Marksman124/center_control/center_control_app/readme.txt

config：

Run #1：

fromelf --bin --output=.\center_control_app\center_control_app.bin .\center_control_app\center_control_app.axf

Run #2：
.\after_build_script.bat "$J\..\bin" "#L" "$L@L.bin"
