Marksman124/center_control/center_control_box/readme.txt

config：

Run #1：

fromelf --bin --output=.\Output\center_control_box.bin .\center_control_box\center_control_box.axf

Run #2：
fromelf --bin --output=..\..\center_control_app\Bin\center_control_box.bin .\center_control_box\center_control_box.axf
