Marksman124/center_control/协议/中控_mcu_modbus_rtu协议V1.3.pdf

### 版本管理

版本号 | 版本时间 | 修改内容 | 修改人
V1.0 | 2023.12.12 | | 吴 珩
V1.1 | 2023.12.19 | | 吴 珩
V1.2 | 2023.12.27 | | 吴 珩
V1.3 | 2024.01.04 | | 吴 珩

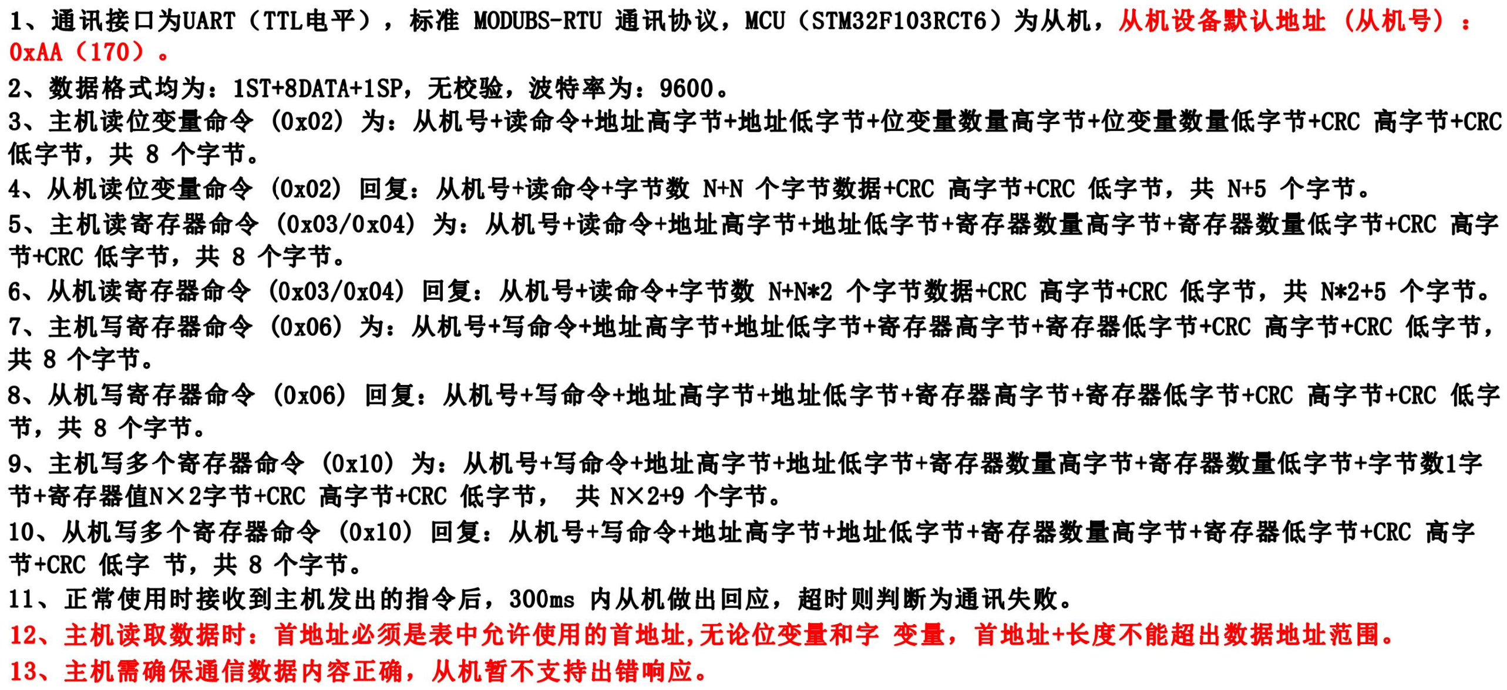
[picture p34: figure]

| | (d) | (d) | | | h | (d)
0x0000 | 从站地址 | 1~254 | 默认 170 | -- | RW | 读：0x03/写：0x06/0x10
0x0001 | 波特率 | 0~65535 | 默认 2 | bps | RW | 读：0x03/写：0x06/0x10 | 1:4800,2:9600,3:19200, 4：115200
0x0002~ 0x0009 | 预留 | | | | | 读：0x03/写：0x06/0x10
0x0010 | 水泵1转速档位 | 0~8 | 默认 0 | -- | RW | 读：0x03/写：0x06/0x10 | 0：断开，1：关闭，2:100%， 3:80%，4:40%
0x0011 | 水泵2转速档位 | 0~8 | 默认 0 | -- | RW | 读：0x03/写：0x06/0x10 | 0：断开，1：关闭，2:100%， 3:80%，4:40%
0x0012 | 水泵1转速输出电流 | 0~100 | 默认 0 | % | RW | 读：0x03/写：0x06/0x10 | 对应4~20mA输出
0x0013 | 水泵2转速输出电流 | 0~100 | 默认 0 | % | RW | 读：0x03/写：0x06/0x10 | 对应4~20mA输出
0x0014 | 水泵1转速输出电压 | 0~4095 | 默认 0 | -- | RW | 读：0x03/写：0x06/0x10 | 对应0~10V输出
0x0015 | 水泵2转速输出电压 | 0~4095 | 默认 0 | -- | RW | 读：0x03/写：0x06/0x10 | 对应0~10V输出
0x0016~ 0x001F | 预留 | | | | | 读：0x03/写：0x06/0x10
0x0020 | 电量计量模块接线方式 | 0~3 | 默认 0 | -- | RW | 读：0x03/写：0x06/0x10 | 0：无模块，1：单相，2：三相三 线，3：三相四线
0x0021 | 电量计量清零 | 1 | 默认 0 | -- | RW | 读：0x03/写：0x06/0x10 | 写入1清零后该地址自动设置为0
0x0022 | 电量计量模块地址 | 0~247 | 默认 0 | -- | RW | 读：0x03/写：0x06/0x10
0x0023 | 电量计量模块波特率 | 0~5 | 默认 0 | -- | RW | 读：0x03/写：0x06/0x10 | 0：无模块，1：2400，2：4800， 3：9600，4：19200，5：115200
0x0024 | 电量计量模块通信格式 | 0~1 | 默认 0 | -- | RW | 读：0x03/写：0x06/0x10 | 0：无模块 1:8数据位，无校验，1停止位

0x0025~ 0x002F | 预留 | | | | | 读：0x03/写：0x06/0x10
0x0030 | DMX512数据长度 | 0~512 | 默认 0 | -- | RW | 读：0x03/写：0x06/0x10 | 灯数据字节数
0x0031~ 0x003F | 预留 | | | | | 读：0x03/写：0x06/0x10
0x0040~ 0x013F | DMX512数据区 | 0~0xFFFF | 默认 0 | | RW | 读：0x03/写：0x06/0x10 | 1个地址存放2个字节灯数据， 0x0040为第1和2个灯数据字节， 往后依次顺延
| | (d) | (d) | | | h | (d)
0x0000 | 软件版本1 | | | -- | R | 读：0x04 / 写：-- | 软件版本高16位
0x0001 | 软件版本2 | | | -- | R | 读：0x04 / 写：-- | 软件版本低16位
0x0002 | 模拟量水位开关状态 | | | m | R | 读：0x04 / 写：-- | 实际水位高度
0x0003~ 0x000F | 预留 | | | -- | R | 读：0x04 / 写：--
0x0010~ 0x0011 | 电网频率 | | | 0.01Hz | R | 读：0x04 / 写：-- | 单相/三相共用，无符号数
0x0012 | 电量计量模块状态字1 | 0~0xFFFF | | -- | R | 读：0x04 / 写：--
0x0013 | 电量计量模块状态字2 | 0~0xFFFF | | -- | R | 读：0x04 / 写：--
0x0014~ 0x0015 | 有功总电能 | | | 0.0001 /0.001 kWh | R | 读：0x04 / 写：-- | 0x0014：高16位，0x0015：低16 位，下同 单相单位：0.0001kWh，无符号数 三相单位：0.001kWh，有符号数
0x0016~ 0x0017 | 正向有功总电能 | | | 0.001 kWh | R | 读：0x04 / 写：-- | 仅三相有效，无符号数
0x0018~ 0x0019 | 反向有功总电能 | | | 0.001 kWh | R | 读：0x04 / 写：-- | 仅三相有效，无符号数

5 0x001A~ 0x001B | 总有功功率 | 0.0001 W/0.00 01kW | R | 读：0x04 / 写：-- | 单相单位：0.0001W，无符号数 三相单位：0.0001kW，有符号数 0x001C~ 0x001D | 总无功功率 | 0.0001 kvar | R | 读：0x04 / 写：-- | 仅三相有效，有符号数 0x001E~ 0x001F | 总视在功率 | 0.0001 kVA | R | 读：0x04 / 写：-- | 仅三相有效，有符号数 0x0020~ 0x0021 | 总功率因素 | 0.001 | R | 读：0x04 / 写：-- | 单相无符号数，三相有符号数 0x0022~ 0x0023 | A相电压 | 0.0001 /0.1V | R | 读：0x04 / 写：-- | 单相单位：0.0001V，无符号数 三相单位：0.1V，无符号数 0x0024~ 0x0025 | A相电流 | 0.0001 /0.001 A | R | 读：0x04 / 写：-- | 单相单位：0.0001A，无符号数 三相单位：0.001A，有符号数 0x0026~ 0x0027 | B相电压 | 0.1V | R | 读：0x04 / 写：-- | 仅三相有效，无符号数 0x0028~ 0x0029 | B相电流 | 0.001A | R | 读：0x04 / 写：-- | 仅三相有效，有符号数 0x002A~ 0x002B | C相电压 | 0.1V | R | 读：0x04 / 写：-- | 仅三相有效，无符号数 0x002C~ 0x002D | C相电流 | 0.001A | R | 读：0x04 / 写：-- | 仅三相有效，有符号数 0x002E~ 0x002F | 零线电流 | 0.001A | R | 读：0x04 / 写：-- | 仅零线接入互感器有效，，有符 号数，预留 0x0030~ 0x003F | 预留 | R | 读：0x04 / 写：--

注：参数的设置范围与默认值请以说明书为标准。

OTA文件传输协议基于modbus-rtu协议21（0x15）写文件记录功能码指令实现，使用该功能码进行文件记录写入，根据字节数量提供所有请求数据

长度，并且根据16比特字的数量提供所有记录长度。用含有7个字节针对每一帧中每一个数据包进行描述：

参考类型 | 1个字节（必须规定为6）
文件号 | 2个字节，默认为：0x0001，代表MCU OTA文件
文件中的起始记录号 | 2个字节，可以作为文件包号
被写入的记录长度 | 2个字节，该包数据长度，2个字节为1个长度
被写入的记录数据 | 每一包的OTA文件内容，2个字节的整数倍（偶数）
- 注：MCU发布的OTA文件保证2个字节的整数倍。

请求数据帧（APP-->MCU）

地址域 | 1个字节 | MCU地址，默认：170（0xAA）
请求数据长度 | 1个字节 | 0x07至0xF5
参考类型 | 1个字节 | 固定为：0x06
文件号 | 2个字节 | 0x0000至0xFFFF，默认为：0x0001，代表MCU OTA文件
记录号 | 2个字节 | 0x0000至0x270F，可以作为文件包号，0xFFFF为最后一个包
记录长度 | 2字节 | N，该包数据长度，2个字节为1个长度
记录数据 | N*2个字节
CRC16 | 2个字节
- 注：
1. 请求数据长度：参考类型（1个字节）+文件号（2个字节）+记录号（2个字节）+记录长度（2个字节）+记录数据 总的字节数（固定有7个字节）。
2. 一个OTA文件包数据记录长度N最大为：（0xF5-0x07）/2=0xEE/2=0x77（119），即一个OTA文件包数据最多为119*2=238字节。
| | (d) | (d) | | h | (d)
0x0000~ 0x00100 | 预留 | | | R | 读：0x02 / 写：--

响应数据帧（APP<--MCU）

地址域 | 1个字节 | MCU地址，默认：170（0xAA）
请求数据长度 | 1个字节 | 0x07至0xF5
参考类型 | 1个字节 | 固定为：0x06
文件号 | 2个字节 | 0x0000至0xFFFF，默认为：0x0001，代表MCU OTA文件
记录号 | 2个字节 | 0x0000至0x270F，可以作为文件包号，0xFFFF为最后一个包
记录长度 | 2字节 | N，该包数据长度，2个字节为1个长度
CRC16 | 2个字节
例程：
请求 | 响应
数据域 | （十六进制） | 备注 | 数据域 | （十六进制） | 备注
地址域 | AA | MCU从站地址，默认0xAA（170） | 地址域 | AA | MCU从站地址，默认0xAA（170）
功能码 | 15 | OTA文件传输功能码指令 | 功能码 | 15 | OTA文件传输功能码指令
请求数据长度 | 0D | 从参考类型至CRC_H（不包含）的总 数据字节数，其中： 参考类型（1字节）+文件号（2字节 ）+记录号（2字节）+记录长度（2字 节）=7字节（固定），记录数据6字 节，共计：7+6=13（0x0D）字节 | 请求数据长度 | 0D | 从参考类型至CRC_H（不包含）的总 数据字节数，其中： 参考类型（1字节）+文件号（2字节 ）+记录号（2字节）+记录长度（2字 节）=7字节（固定），记录数据6字 节，共计：7+6=13（0x0D）字节
参考类型 | 06 | 固定默认为06 | 参考类型 | 06 | 固定默认为06
文件号Hi | 00 | MCU的OTA文件，默认0x0001 | 文件号Hi | 00 | MCU的OTA文件，默认0x0001 文件号Lo
| 01 | | 文件号Lo | 01
记录号Hi | 00 07 | 当前传输包号为7（从0开始计算） | 记录号Hi 记录号Lo | 00 07 | 当前传输包号为7（从0开始计算） 记录号Lo
记录长度Hi | 00 | 包号为7的数据内容长度，本例为3， 共3*2=6字节 | 记录长度Hi | 00 | 包号为7的数据内容长度，本例为3， 共3*2=6字节
记录长度Lo | 03 | | 记录长度Lo | 03
记录数据Hi | 06 | 包号为7的文件数据内容，不需要进 行大端高/低字节交换，按照读取OTA 文件该包号从低到高字节（2字节倍 数）顺序发送即可。 | CRC_H | CF | CRC_H（不包含）以上所有字节CRC16 校验结果数据
记录数据Lo | AF | | CRC_L | AC
记录数据Hi | 04
记录数据Lo | BE
记录数据Hi | 10
记录数据Lo | 0D

CRC_H | F8 | CRC_H（不包含）以上所有字节CRC16 校验结果数据
CRC_L | 88
- 注：Hi对应高字节，Lo对应低字节，CRC_H对应CRC高字节，CRC_L对应CRC低字节。
