Marksman124/center_control/资料/IM1275电能计量模块资料包V1.4/IM1275计量院测试报告.pdf

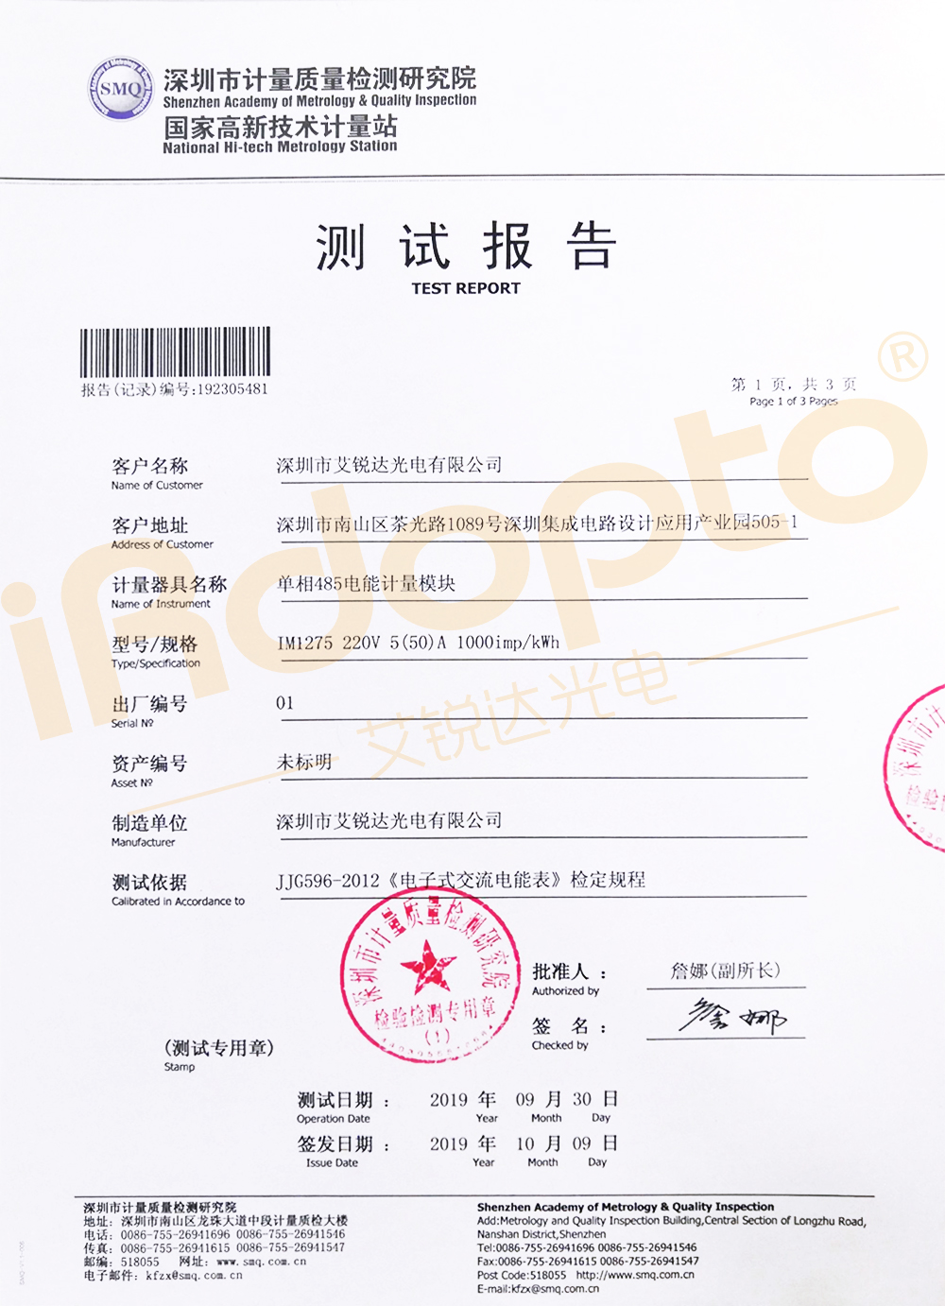
[picture p35: page 1]
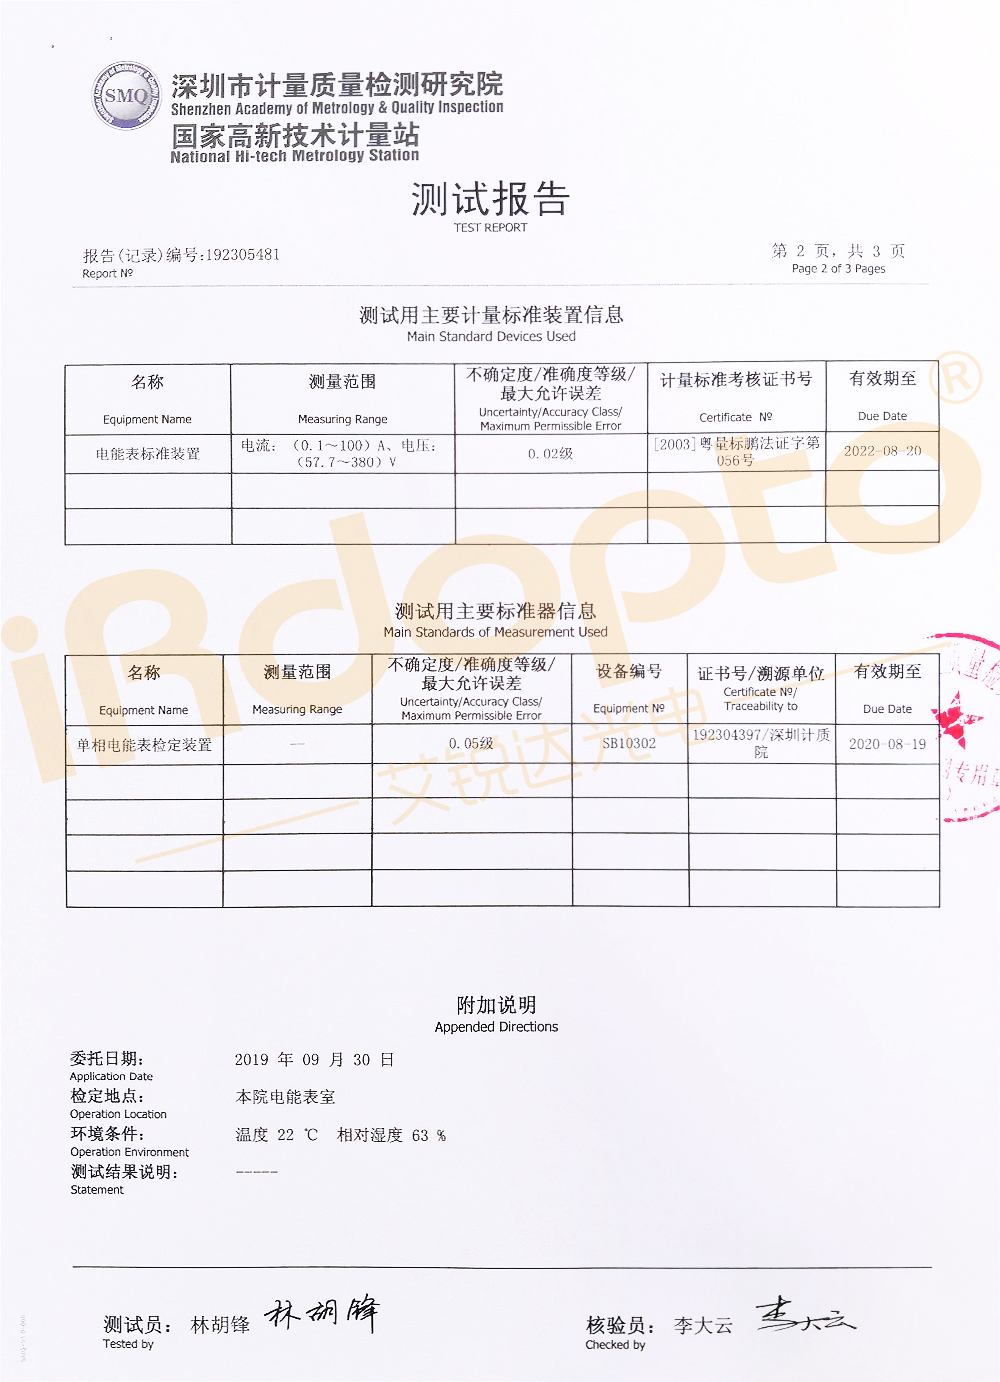
[picture p36: page 2]
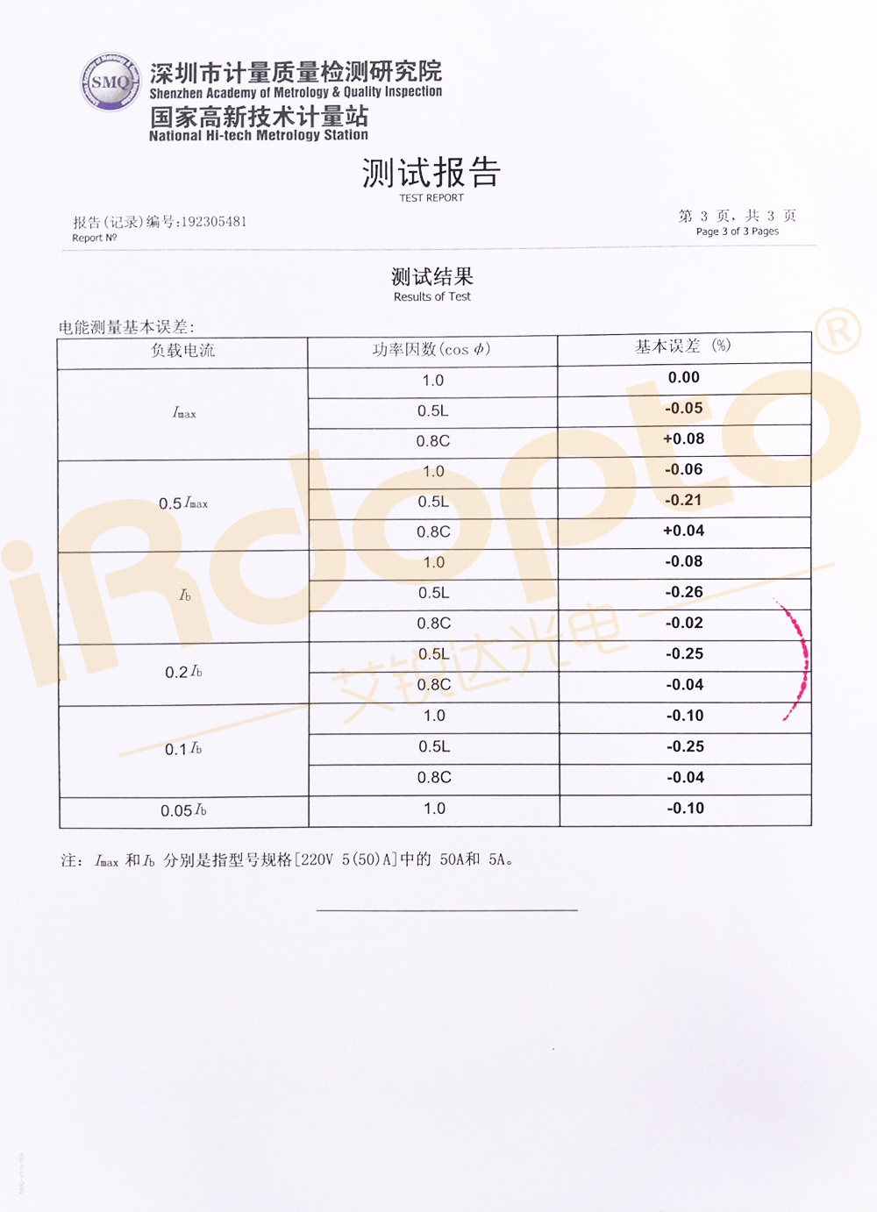
[picture p37: page 3]
