Marksman124/center_control/资料/IM3332三相电能计量模块资料包V1.3/IM3332 计量院检测报告202209.pdf

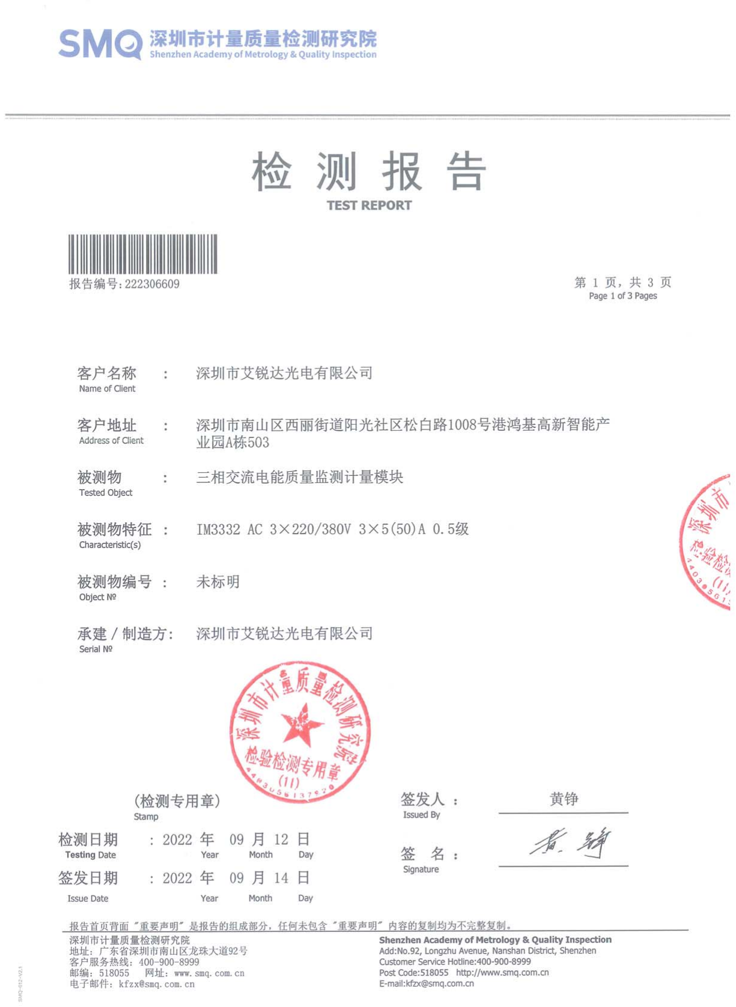
[picture p38: page 1]
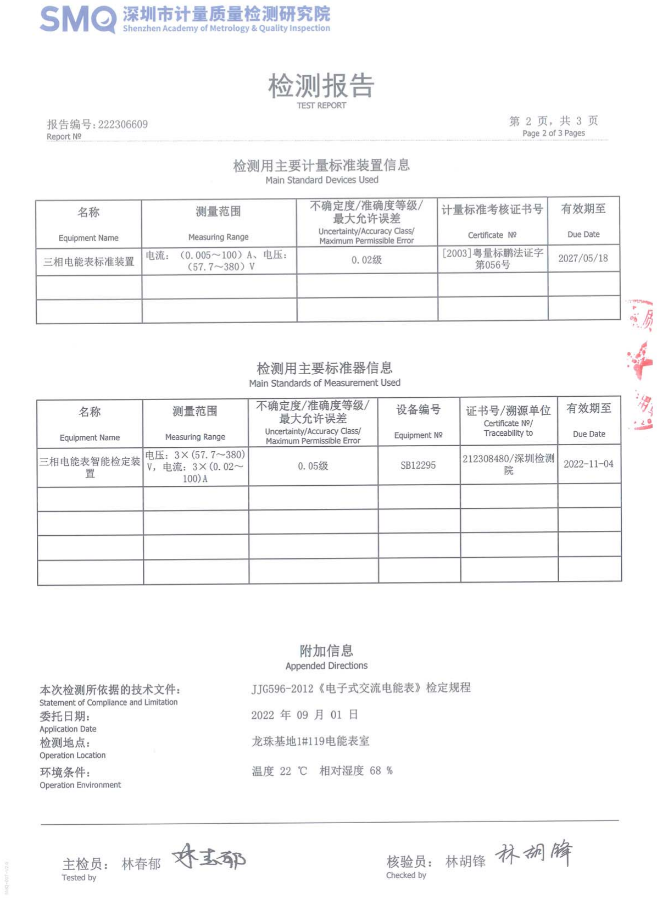
[picture p39: page 2]
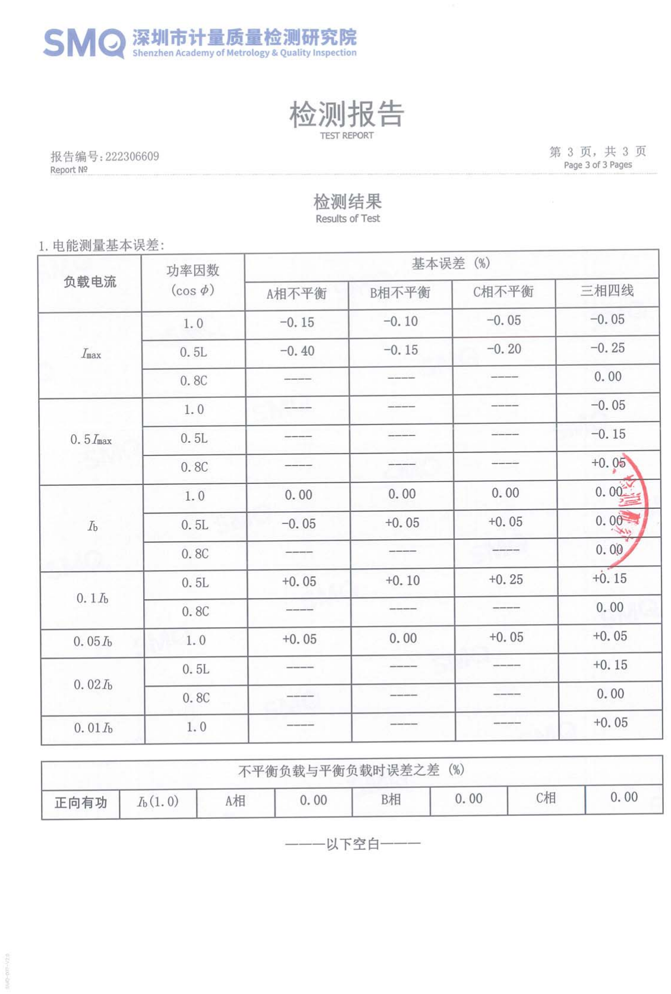
[picture p40: page 3]
