Marksman124/center_control/协议/中控_mcu_modbus_rtu协议V1.0.pdf

版本管理 版本号 | 版本时间 | 修改内容 | 修改人 V1.0 | 2023.12.12 | 吴 珩


| | (d) | (d) | | | h | (d)
0x0000 | 从站地址 | 1~254 | 默认 170 | -- | RW | 读：0x03/写：0x06/0x10
0x0001 | 波特率1 | 0~65535 | 默认 9600 | bps | RW | 读：0x03/写：0x06/0x10 | 波特率低16位
0x0002 | 波特率2 | 0~65535 | 默认 0 | bps | RW | 读：0x03/写：0x06/0x10 | 波特率高16位
0x0003~ 0x0009 | 预留 | | | | | 读：0x03/写：0x06/0x10
0x0010 | 水泵1转速档位 | 0~8 | 默认 0 | -- | RW | 读：0x03/写：0x06/0x10 | 0：关闭，值越大转速档位越高
0x0011 | 水泵2转速档位 | 0~8 | 默认 0 | -- | RW | 读：0x03/写：0x06/0x10 | 0：关闭，值越大转速档位越高
0x0012 | 水泵1转速输出电流 | 0~100 | 默认 0 | % | RW | 读：0x03/写：0x06/0x10 | 对应4~20mA输出
0x0013 | 水泵2转速输出电流 | 0~100 | 默认 0 | % | RW | 读：0x03/写：0x06/0x10 | 对应4~20mA输出
0x0014 | 水泵1转速输出电压 | 0~4095 | 默认 0 | -- | RW | 读：0x03/写：0x06/0x10 | 对应0~10V输出
0x0015 | 水泵2转速输出电压 | 0~4095 | 默认 0 | -- | RW | 读：0x03/写：0x06/0x10 | 对应0~10V输出
0x0016~ 0x0019 | 预留 | | | | | 读：0x03/写：0x06/0x10
0x0020 | 电量计量清零 | 1 | 默认 0 | -- | RW | 读：0x03/写：0x06/0x10 | 写入1清零后该地址自动设置为0
0x0020~ 0x002F | 预留 | | | | | 读：0x03/写：0x06/0x10
0x0030 | DMX512数据长度 | 0~512 | 默认 0 | -- | RW | 读：0x03/写：0x06/0x10 | 灯数据字节数
0x0031~ 0x003F | 预留 | | | | | 读：0x03/写：0x06/0x10
0x0040~ 0x013F | DMX512数据区 | 0~0xFFFF | 默认 0 | | RW | 读：0x03/写：0x06/0x10 | 1个地址存放2个字节灯数据， 0x0040为第1和2个灯数据字节， 往后依次顺延

5 | (d) | (d) | h | (d) 0x0000 | 软件版本1 | -- | R | 读：0x04 / 写：-- | 软件版本低16位 0x0001 | 软件版本2 | -- | R | 读：0x04 / 写：-- | 软件版本高16位 0x0002 | 模拟量水位开关状态 | m | R | 读：0x04 / 写：-- | 实际水位高度 0x0003~ 0x000F | 预留 | -- | R | 读：0x04 / 写：-- 0x0010 | 电量计量模块接线类型 | -- | R | 读：0x04 / 写：-- | 0x01：单相 0x55：三相四线制 0xAA：三相三线制 0x0011 | 电网频率 | Hz | R | 读：0x04 / 写：-- 0x0012 | 电量计量模块状态字1 | 0~0xFFFF | -- | R | 读：0x04 / 写：-- 0x0012 | 电量计量模块状态字2 | 0~0xFFFF | -- | R | 读：0x04 / 写：-- 0x0014 | 有功总电能 | 0.01 kWh | R | 读：0x04 / 写：-- | 单相/三相共用 0x0015 | 正向有功总电能 | 0.01 kWh | R | 读：0x04 / 写：-- | 仅三相有效 0x0016 | 反向有功总电能 | 0.01 kWh | R | 读：0x04 / 写：-- | 仅三相有效 0x0017 | 总有功功率 | 0.0001 kW | R | 读：0x04 / 写：-- | 单相/三相共用 0x0018 | 总无功功率 | 0.0001 kvar | R | 读：0x04 / 写：-- | 仅三相有效 0x0019 | 总视在功率 | 0.0001 kVA | R | 读：0x04 / 写：-- | 仅三相有效 0x0020 | 总功率因素 | 0.001 | R | 读：0x04 / 写：-- | 单相/三相共用 0x0021 | A相电压 | 0.1V | R | 读：0x04 / 写：-- | 单相/三相共用 0x0022 | A相电流 | 0.001A | R | 读：0x04 / 写：-- | 单相/三相共用 0x0023 | B相电压 | 0.1V | R | 读：0x04 / 写：-- | 仅三相有效 0x0024 | B相电流 | 0.001A | R | 读：0x04 / 写：-- | 仅三相有效

注：参数的设置范围与默认值请以说明书为标准。

0x0025 | C相电压 | 0.1V | R | 读：0x04 / 写：-- | 仅三相有效
0x0026 | C相电流 | 0.001A | R | 读：0x04 / 写：-- | 仅三相有效
0x0027~ 0x0030 | 预留 | | R | 读：0x04 / 写：--
| | (d) | (d) | | h | (d)
0x0000~ 0x00100 | 预留 | | | R | 读：0x02 / 写：--
