Marksman124/center_control/资料/IM3332三相电能计量模块资料包V1.3/IM3332定位孔尺寸.png

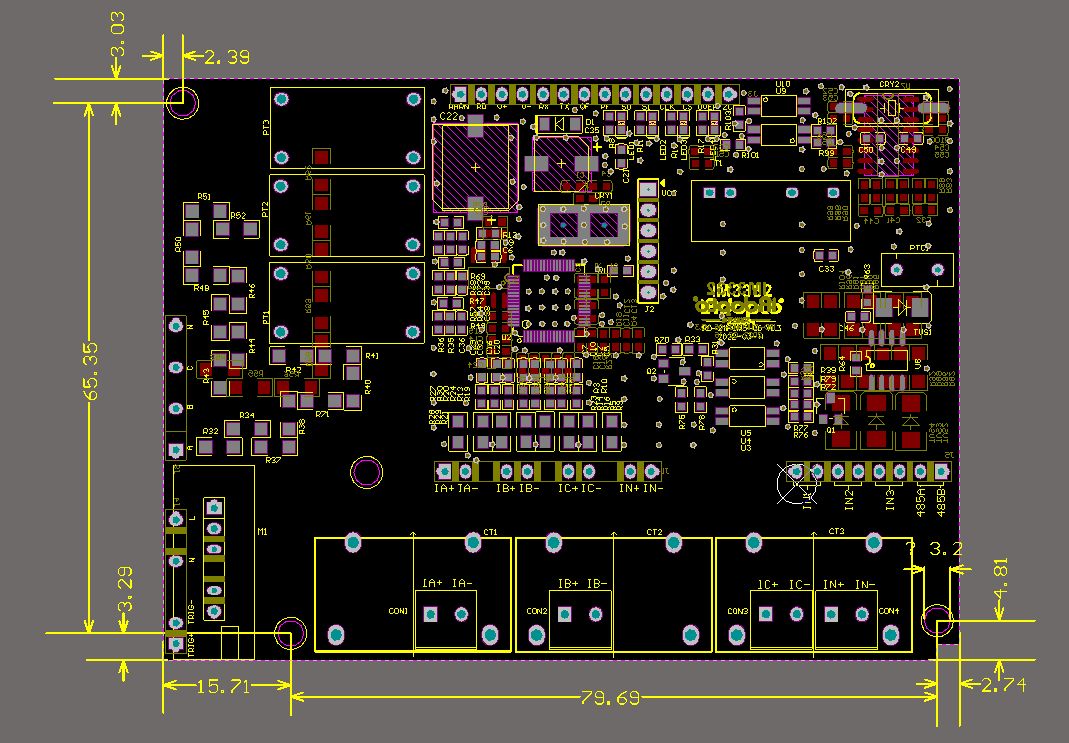
资料/IM3332三相电能计量模块资料包V1.3/IM3332定位孔尺寸.png
