Marksman124/center_control/资料/lQLPJw6vsxUtuK_NBITNAx2wI1InRiWbrwsFhp_jsBXTAQ_797_1156.png

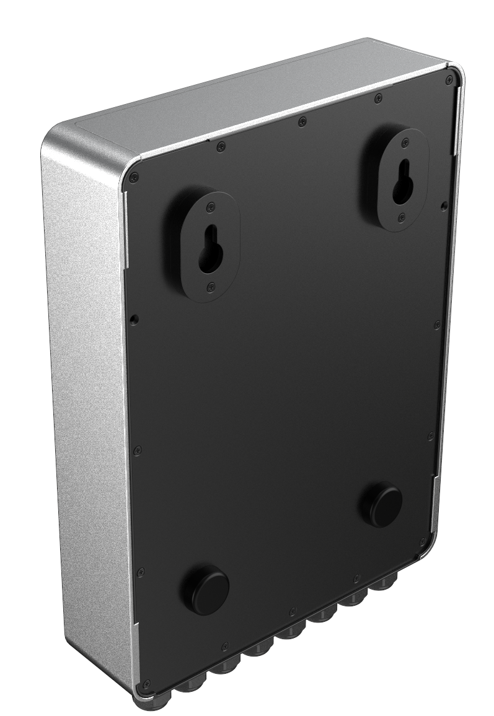
资料/lQLPJw6vsxUtuK_NBITNAx2wI1InRiWbrwsFhp_jsBXTAQ_797_1156.png
