Marksman124/center_control/资料/lQLPJwHTVCcXeK_NA9vNAwawpavTkDDjZVQFhp_jsBXTAw_774_987.png

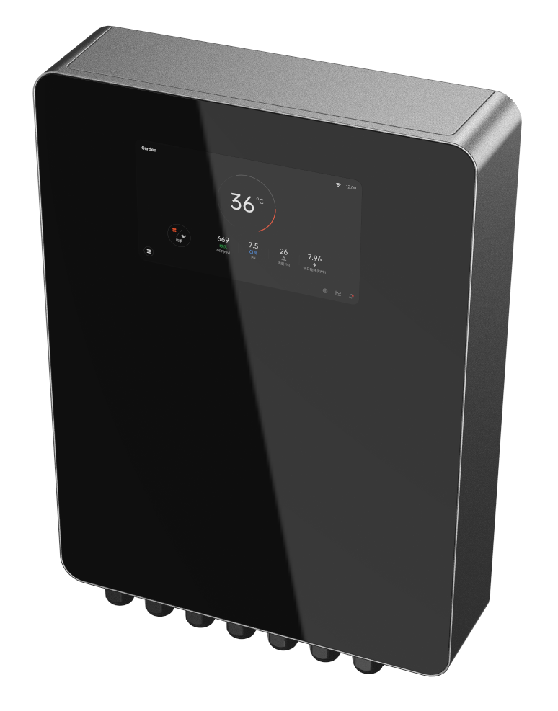
资料/lQLPJwHTVCcXeK_NA9vNAwawpavTkDDjZVQFhp_jsBXTAw_774_987.png
