Marksman124/center_control/资料/lQLPJwtq9uP8OK_NBAPNAsewVGl3I03FFfEFhp_jsBXTAA_711_1027.png

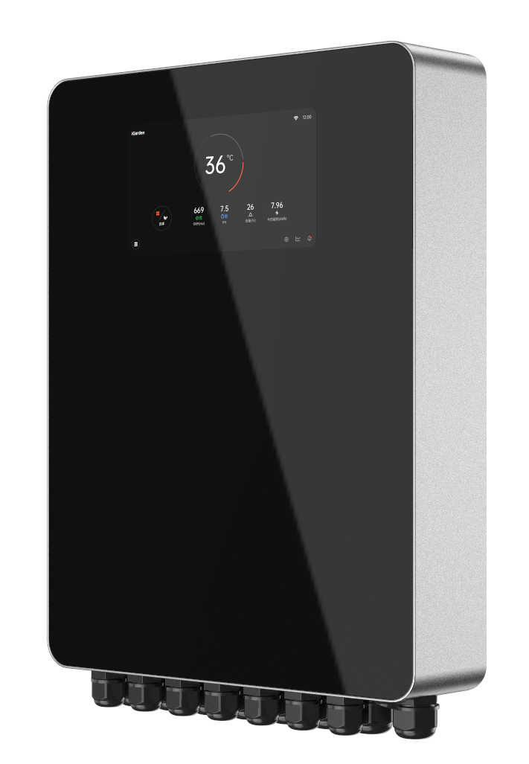
资料/lQLPJwtq9uP8OK_NBAPNAsewVGl3I03FFfEFhp_jsBXTAA_711_1027.png
