Marksman124/center_control/资料/lQLPKd925OXayK_NBDvNBFKwM_CNws2gdIkFhp_jsBXTAg_1106_1083.png

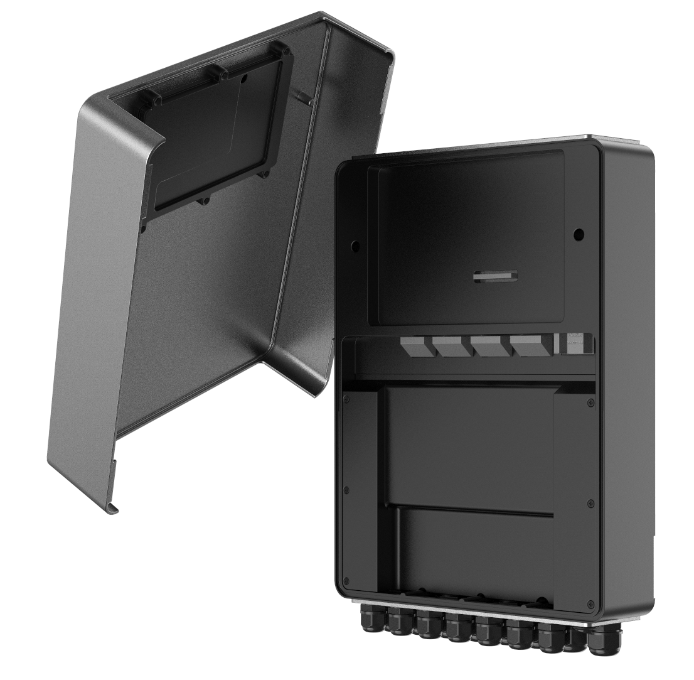
资料/lQLPKd925OXayK_NBDvNBFKwM_CNws2gdIkFhp_jsBXTAg_1106_1083.png
