Marksman124/center_control/原理图/Schematic Prints.pdf

# USB-HOST

# USB-OTG

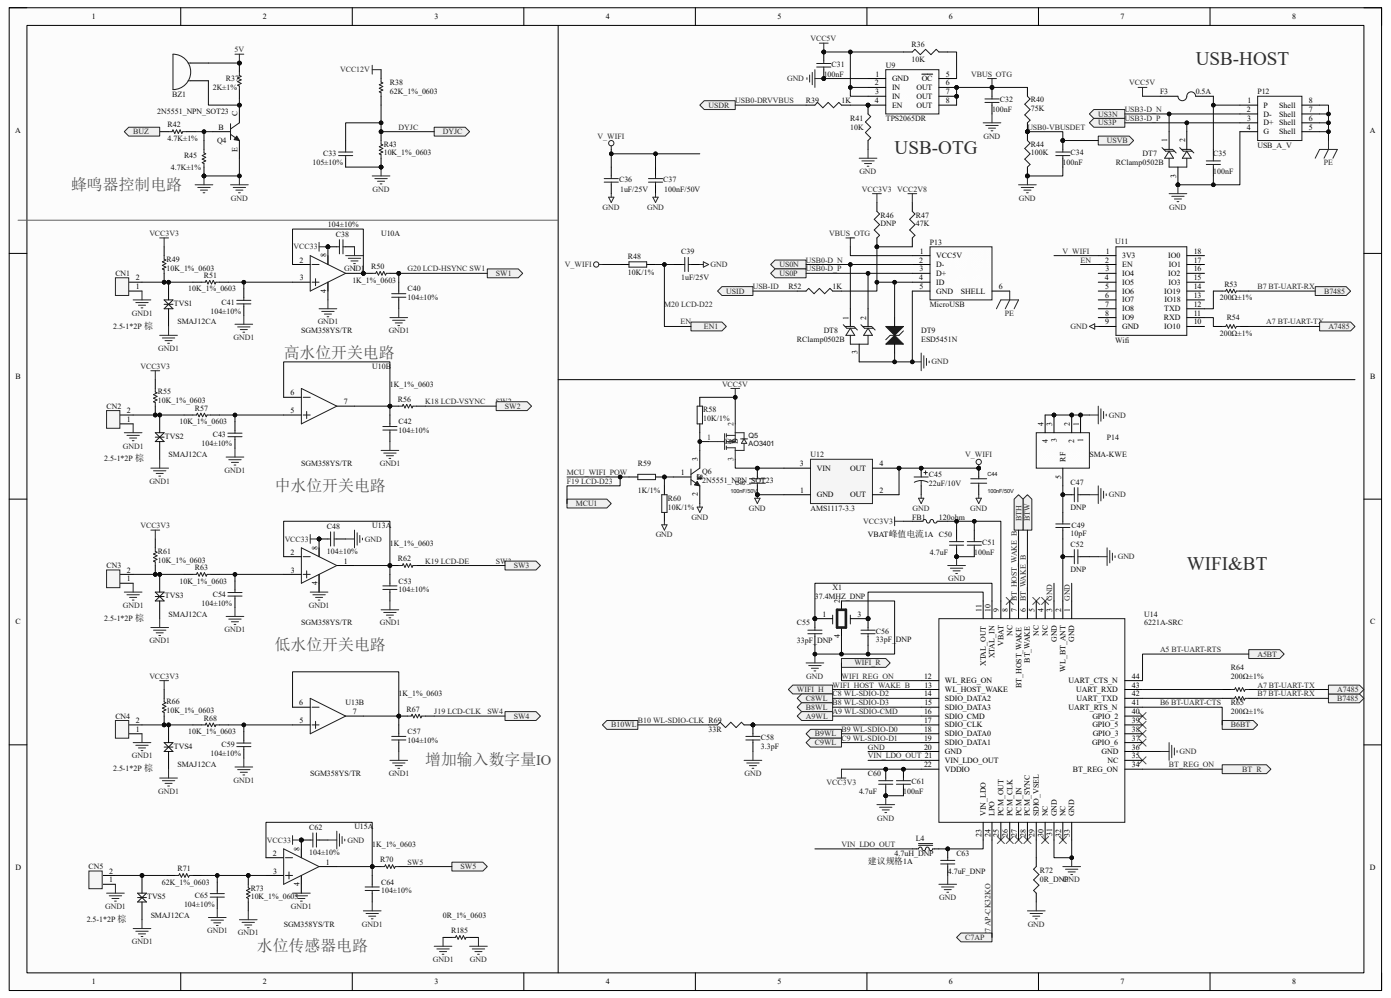
[picture p46: page 1]

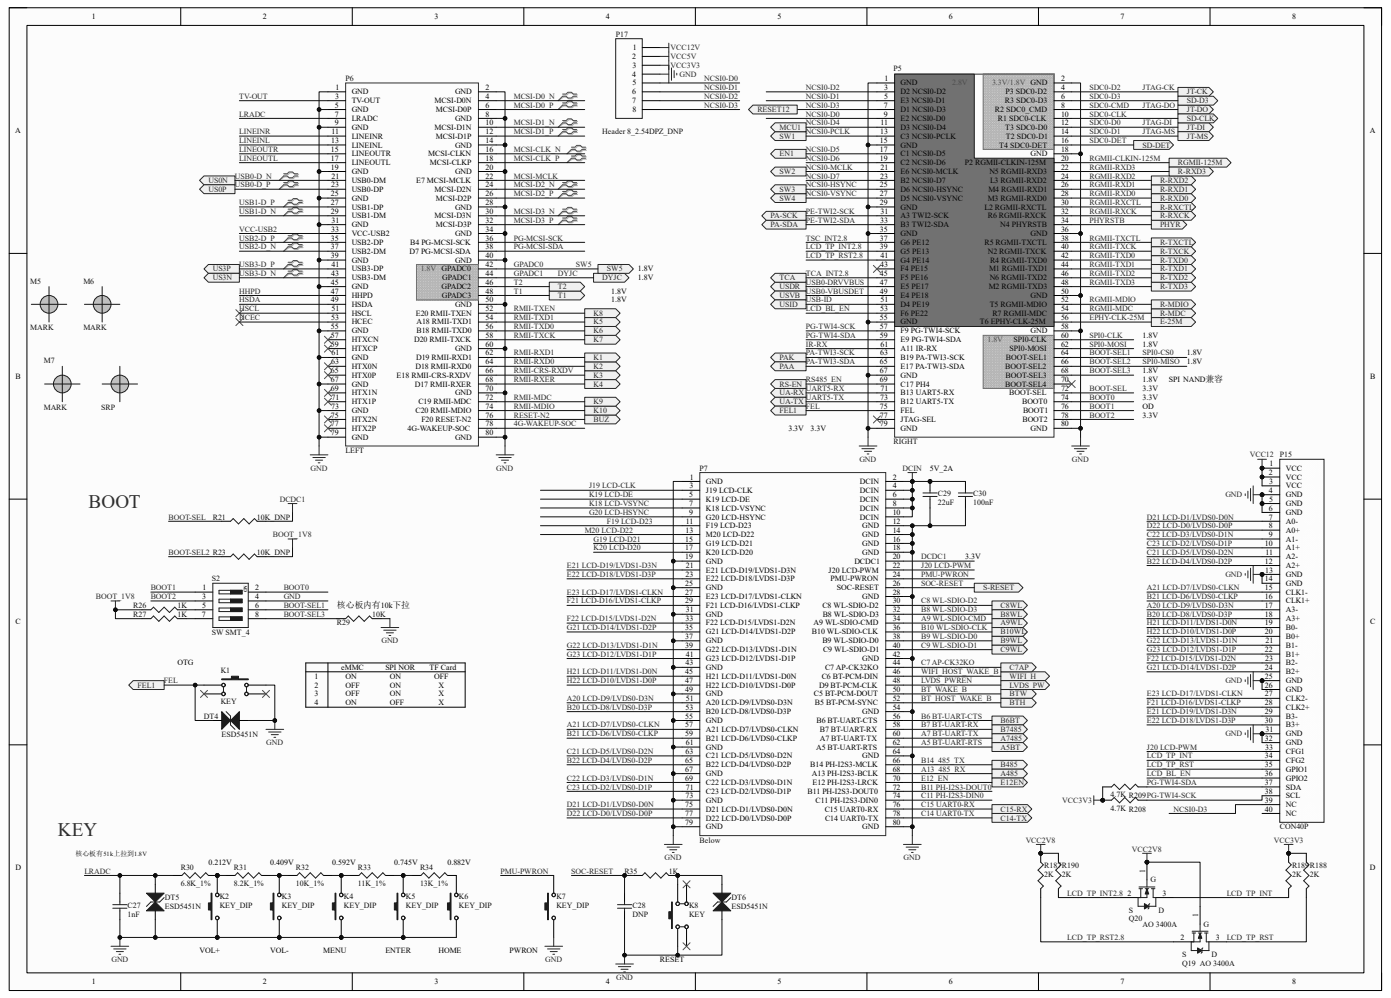
[picture p47: page 2]

# TF Card

# POWER

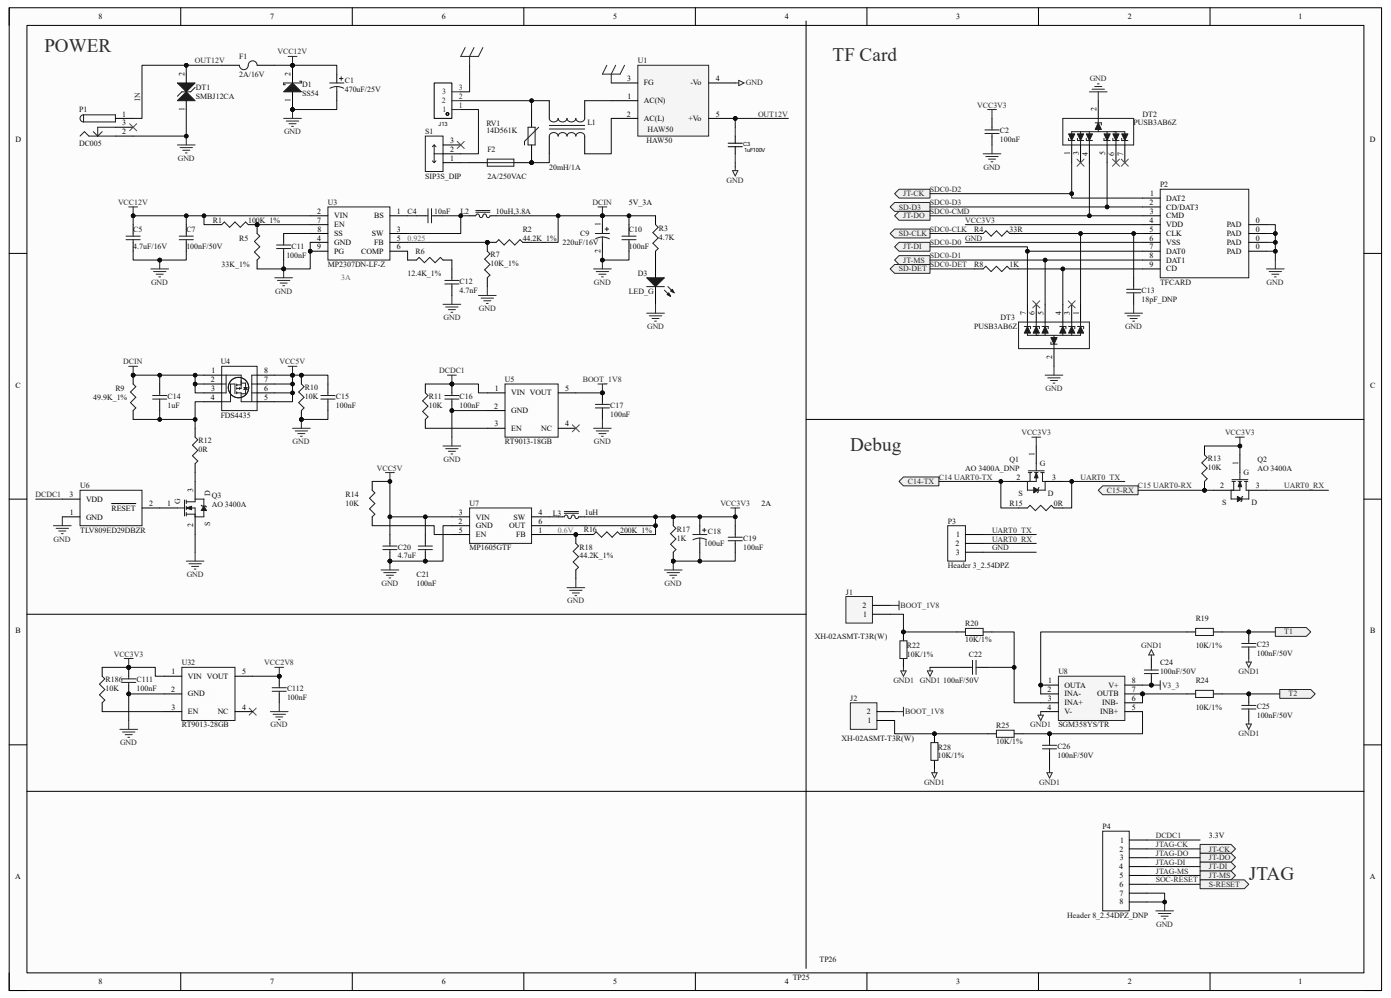
[picture p48: page 3]

LV

D

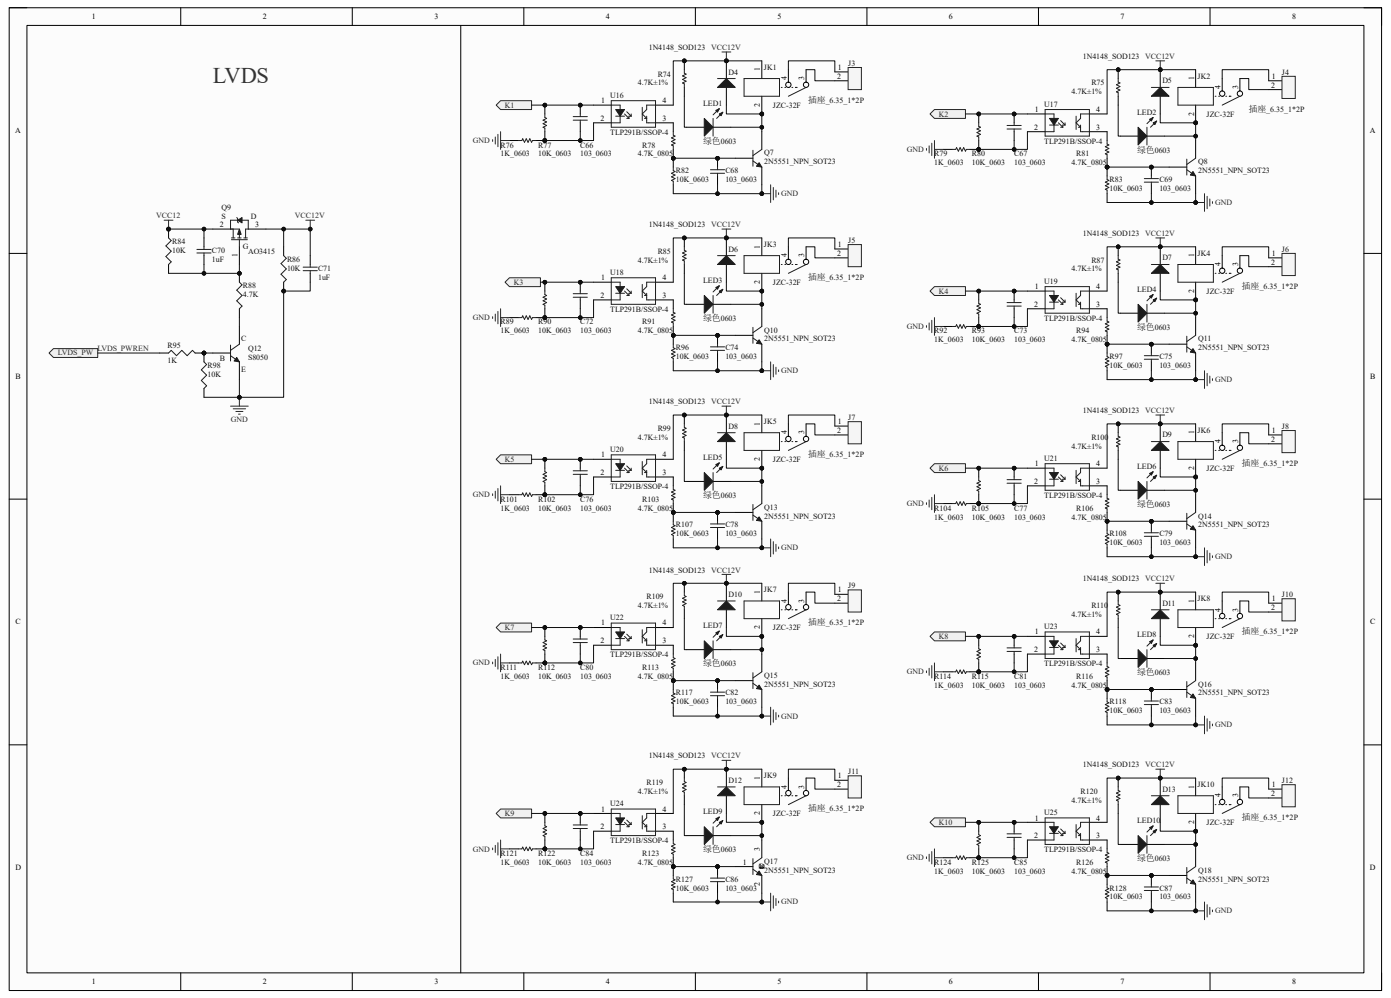
[picture p49: page 4]

# RS485通信电路

0~10V

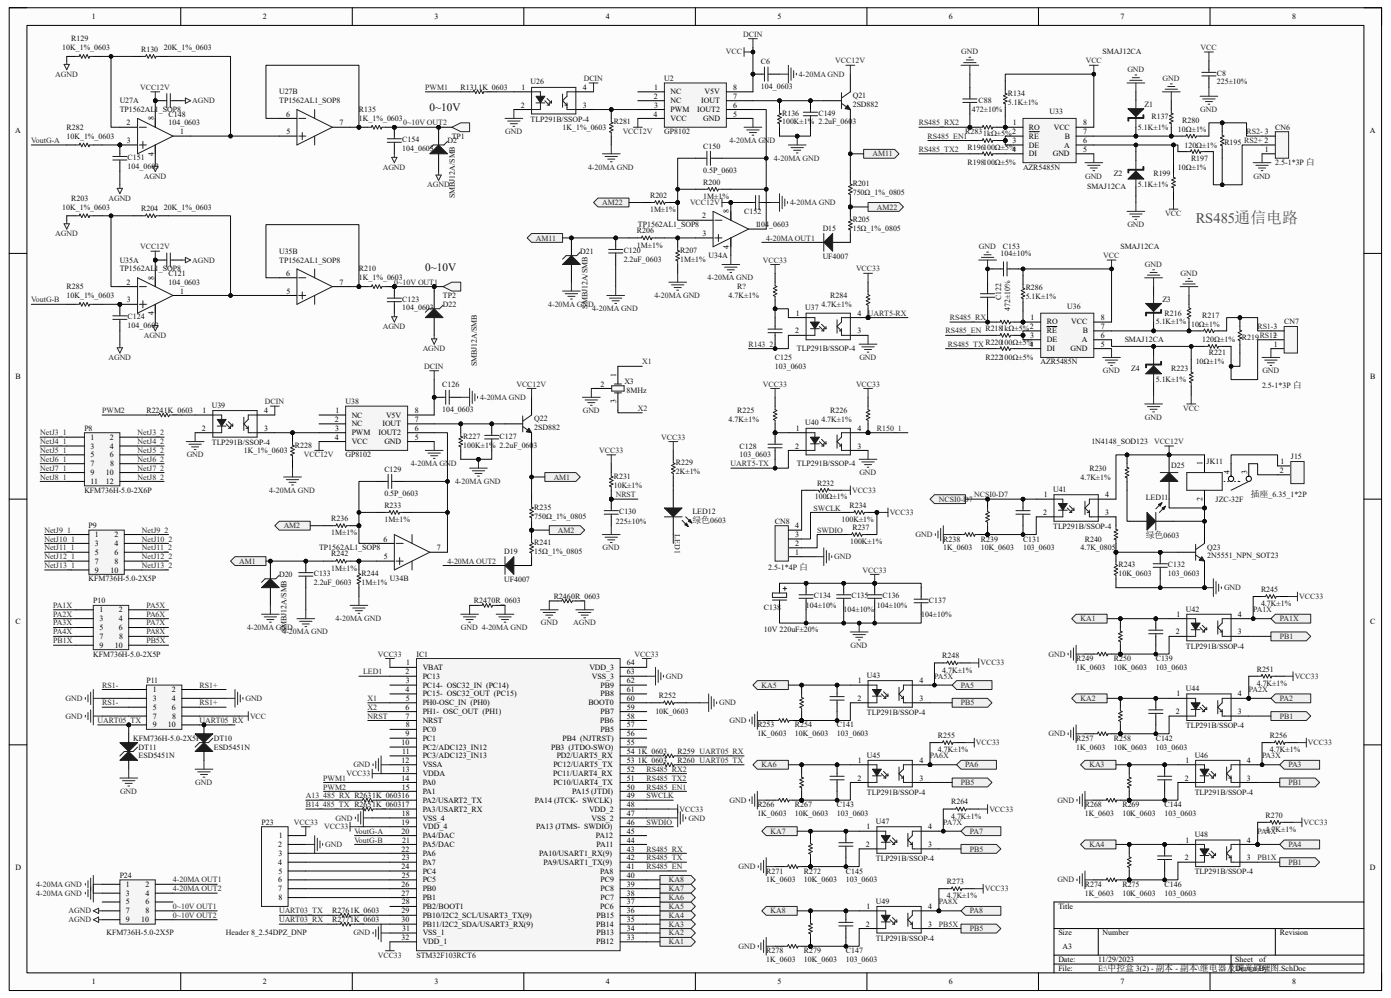
[picture p50: page 5]

A | A

R181

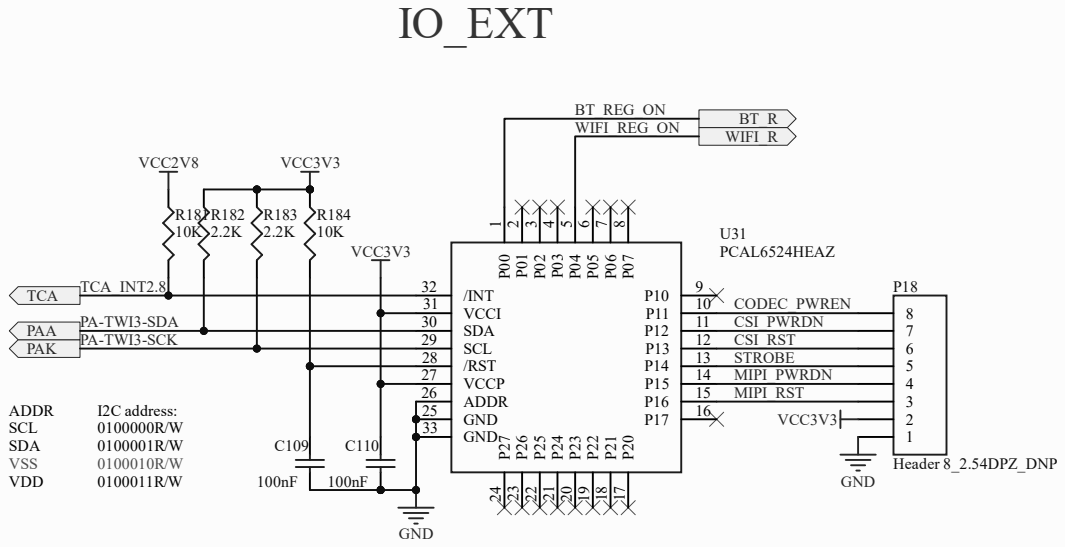
[picture p51: page 6]

# Gigabit Ethernet

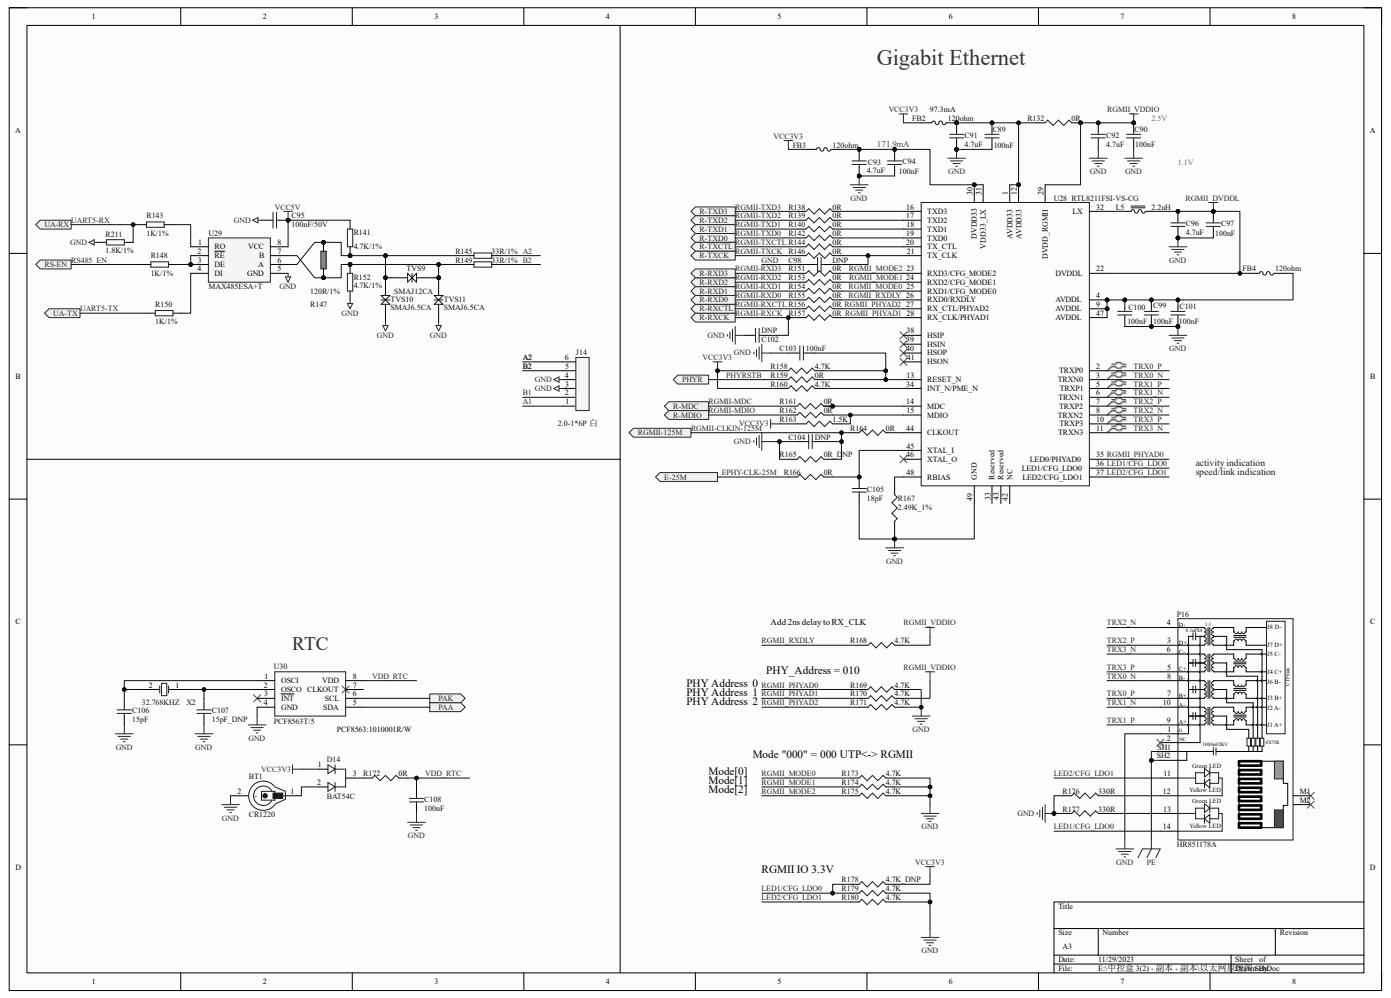
[picture p52: page 7]

D | D
C | C
B | B
A | A

总原理图

## IMT-2CP1-AC220-STM32F103.SchDoc

总原理图

## 电源原理图.SchDoc

总原理图

## BN模块.SchDoc

总原理图

## 以太网原理图.SchDoc

总原理图

## 计量原理图.SchDoc

总原理图
继电器及调光原理图.SchDoc

总原理图

## 漏电保护.SchDoc
