Marksman124/center_control/原理图/中控原理图.pdf

# USB-HOST

# VBUS_OTG 3

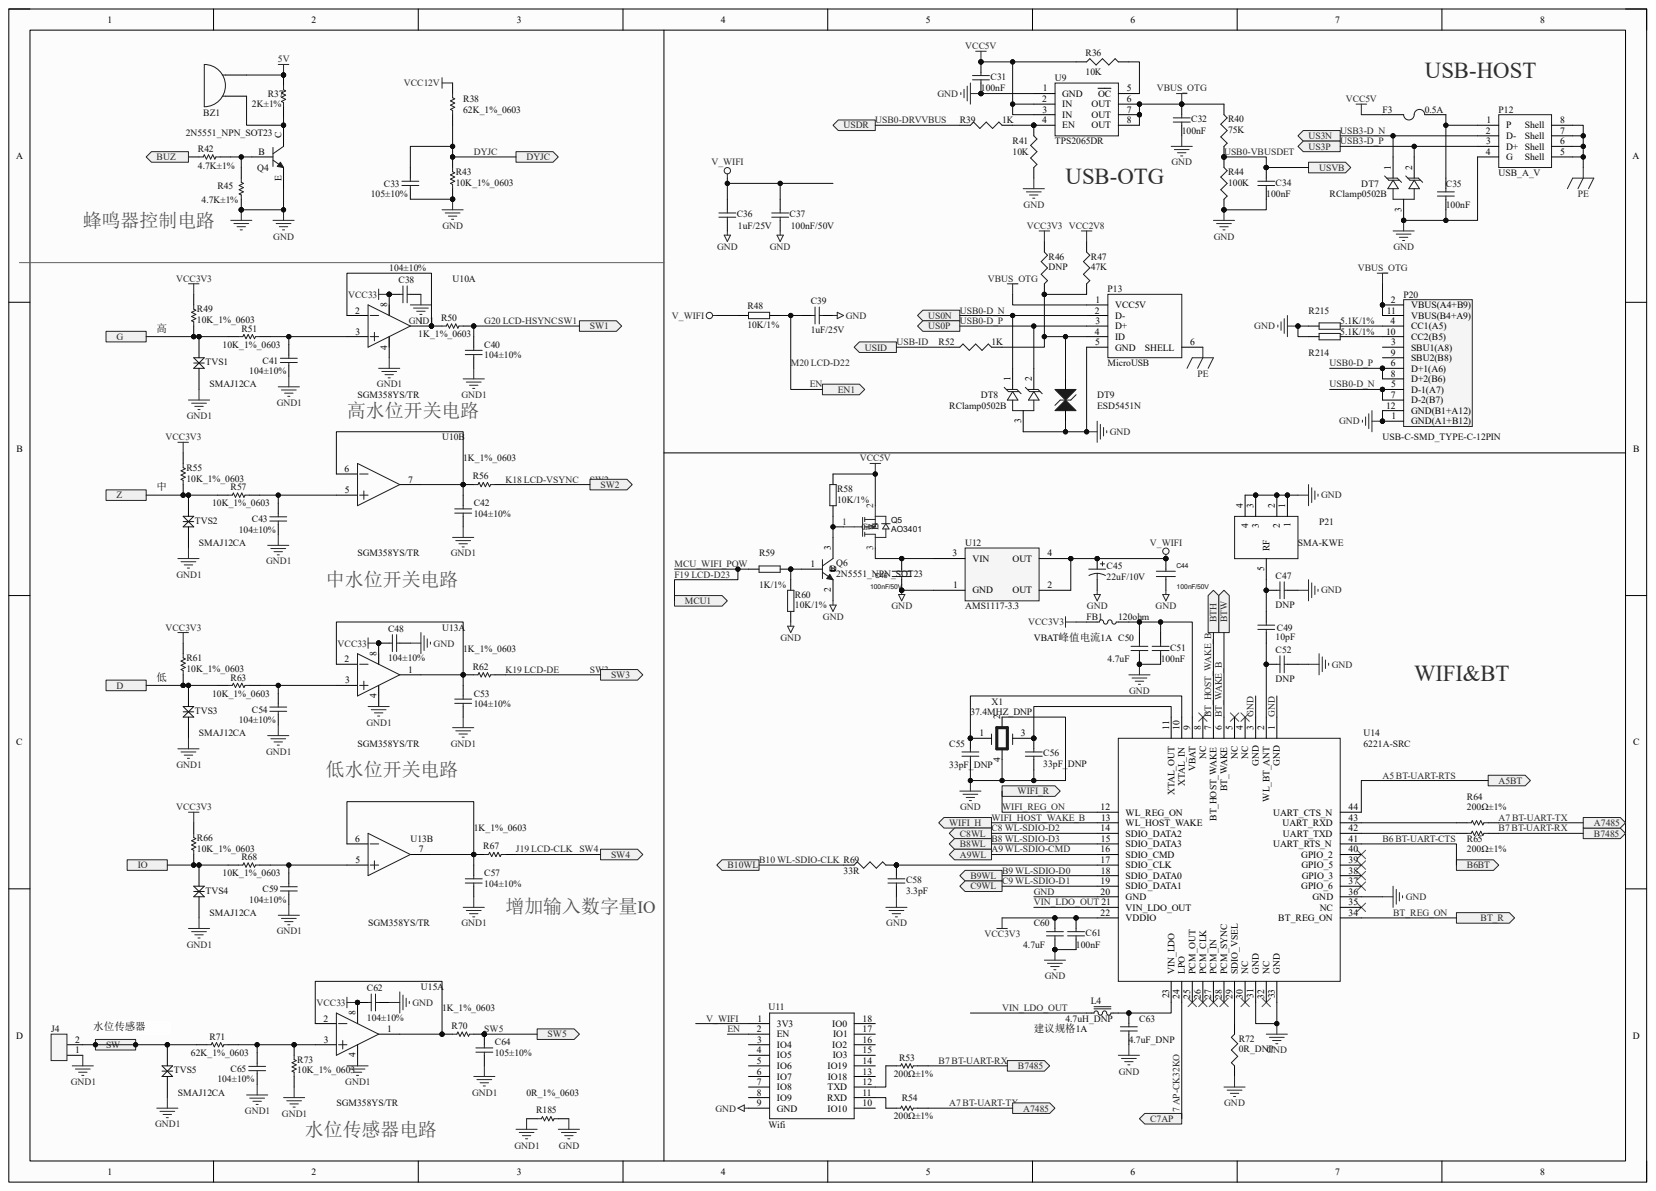
[picture p53: page 1]

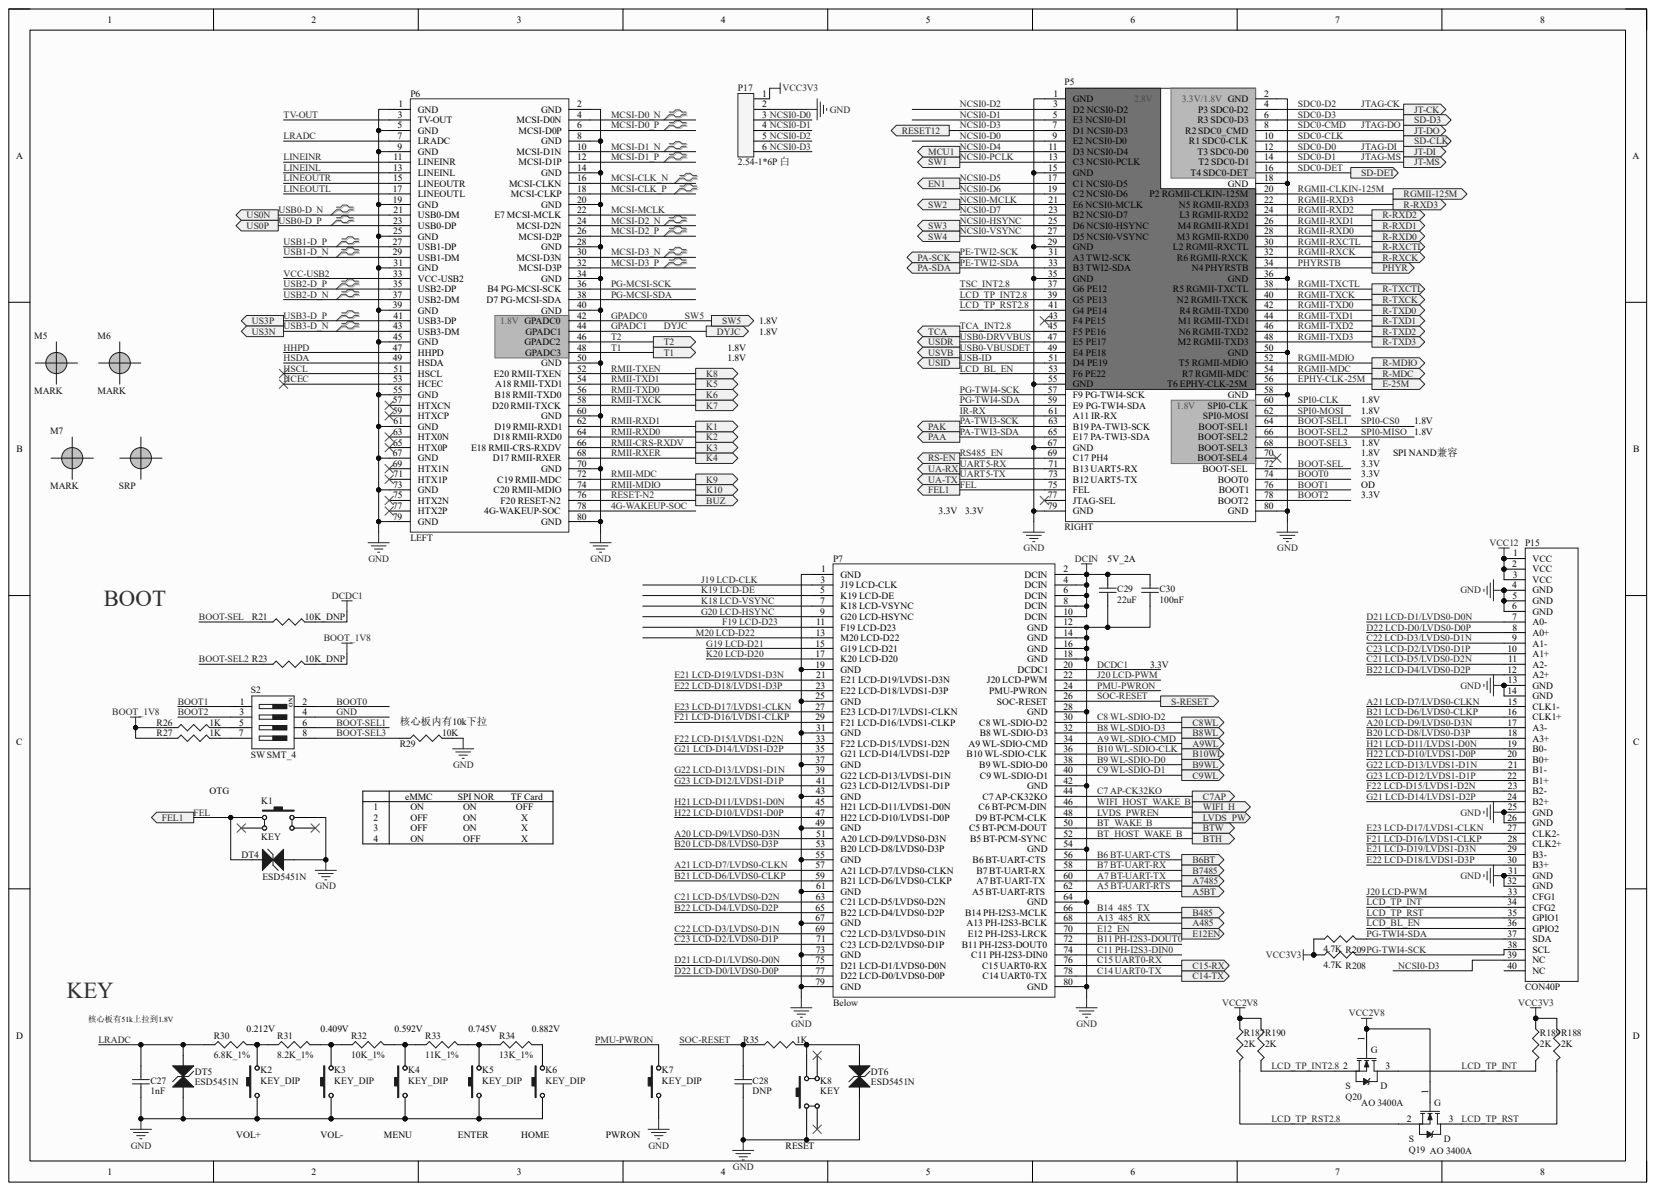
[picture p54: page 2]

eMMC SPI NOR TF Card
1 2 3 4 | ON ON OFF OFF ON X OFF ON X ON OFF X

# TF Card

# POWER

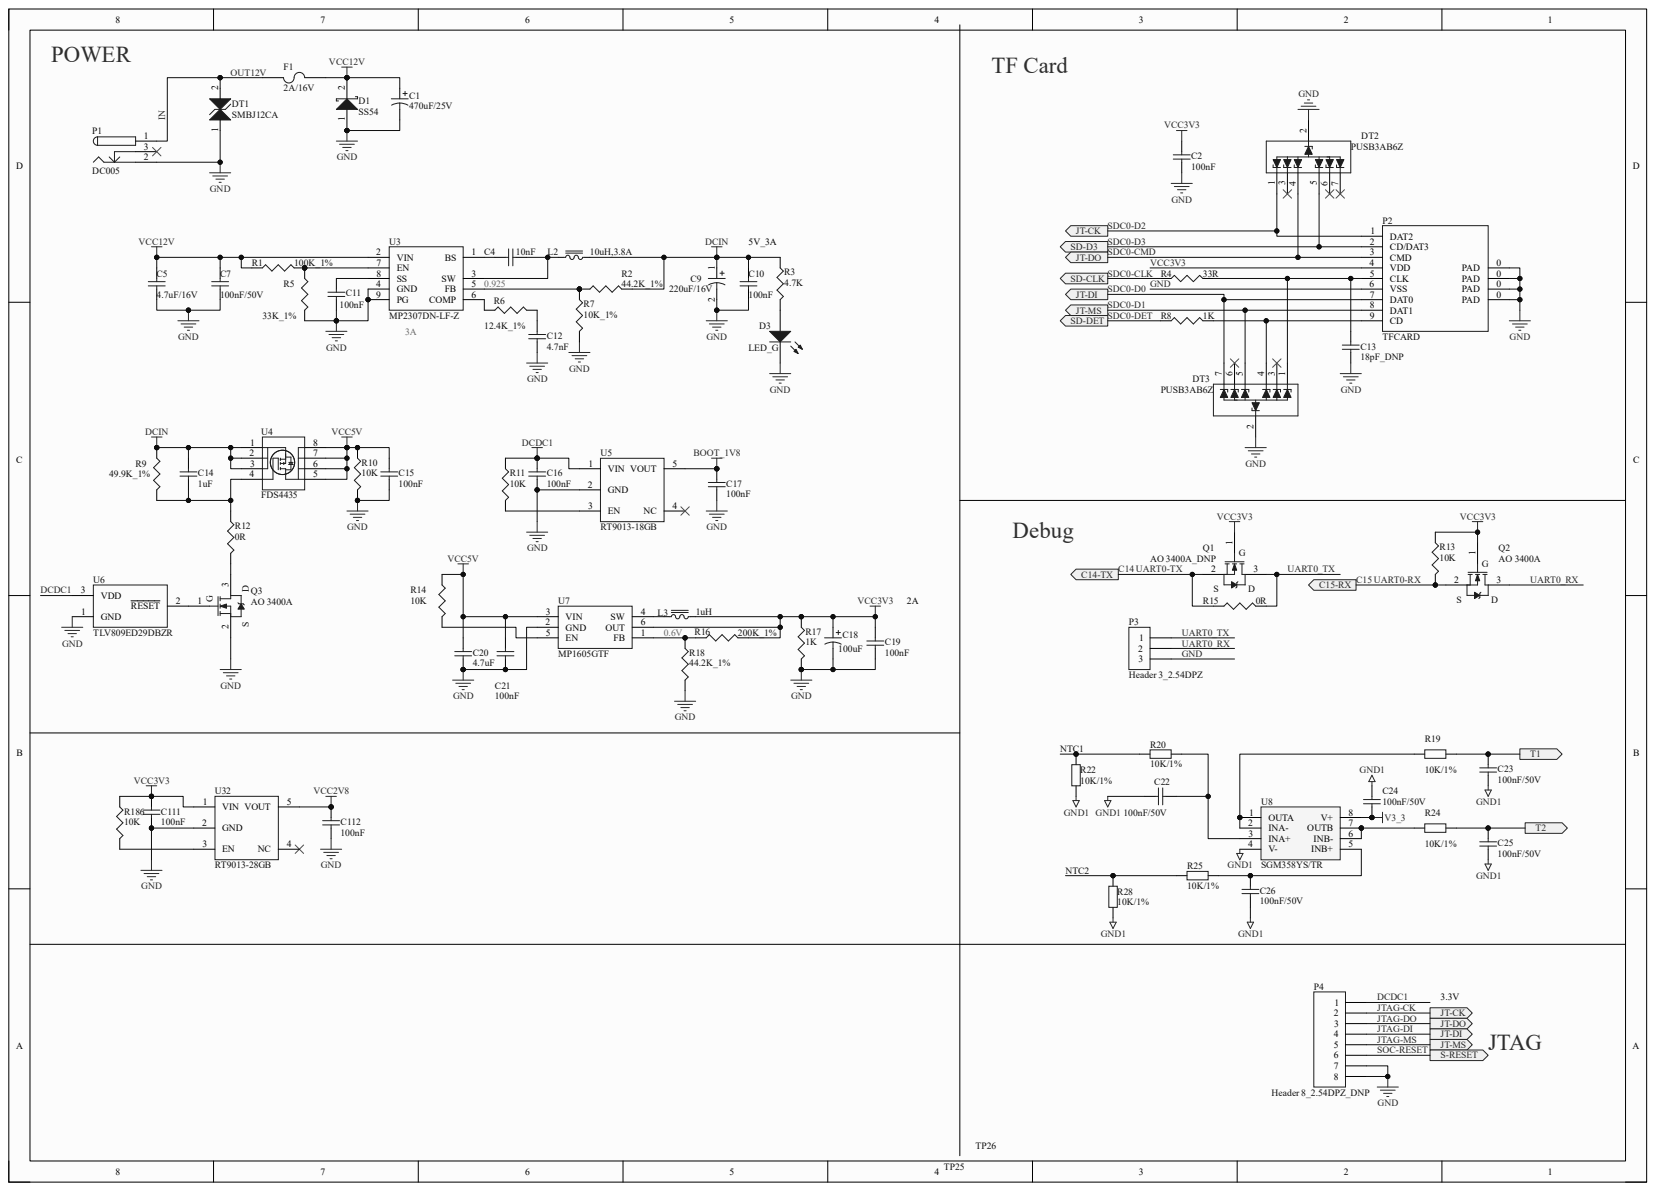
[picture p55: page 3]

GND ³ ² ¹ | 4
GND ³ ² ¹ | 4

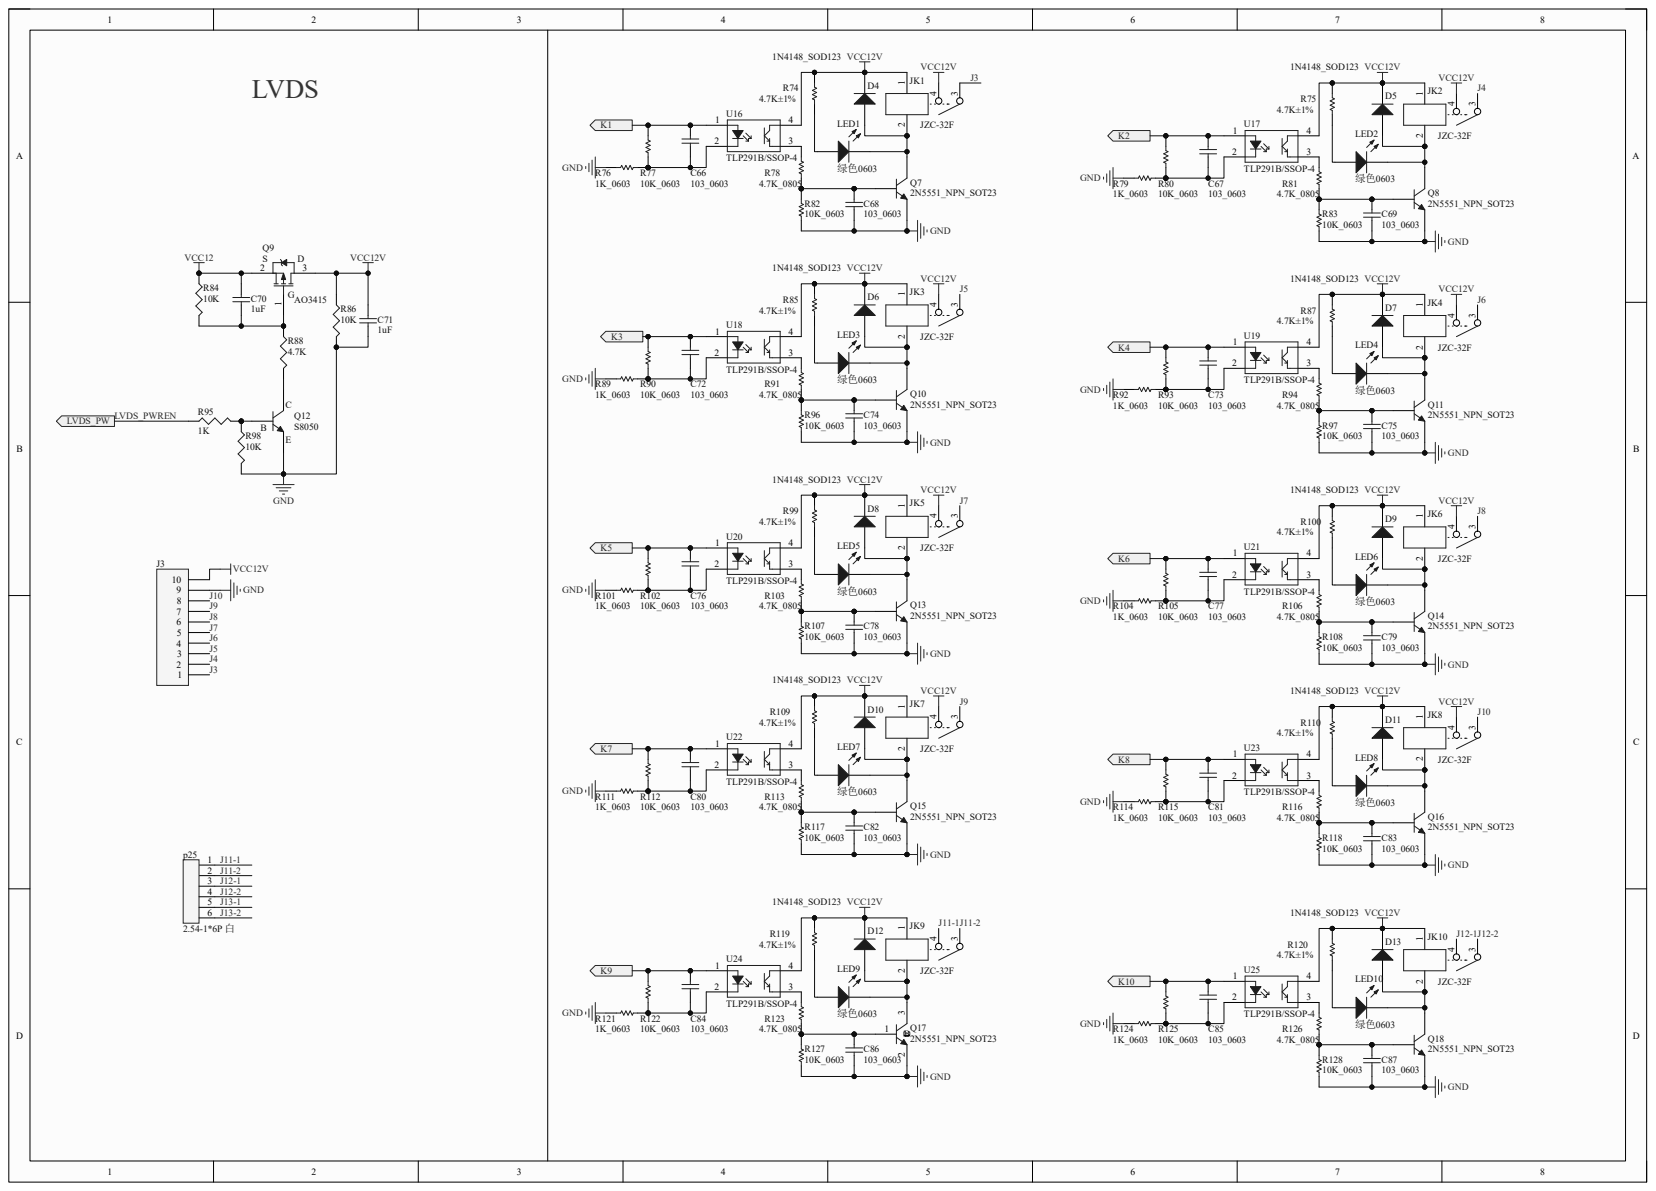
[picture p56: page 4]

# RS485通信电路

# VCC12V 8 4

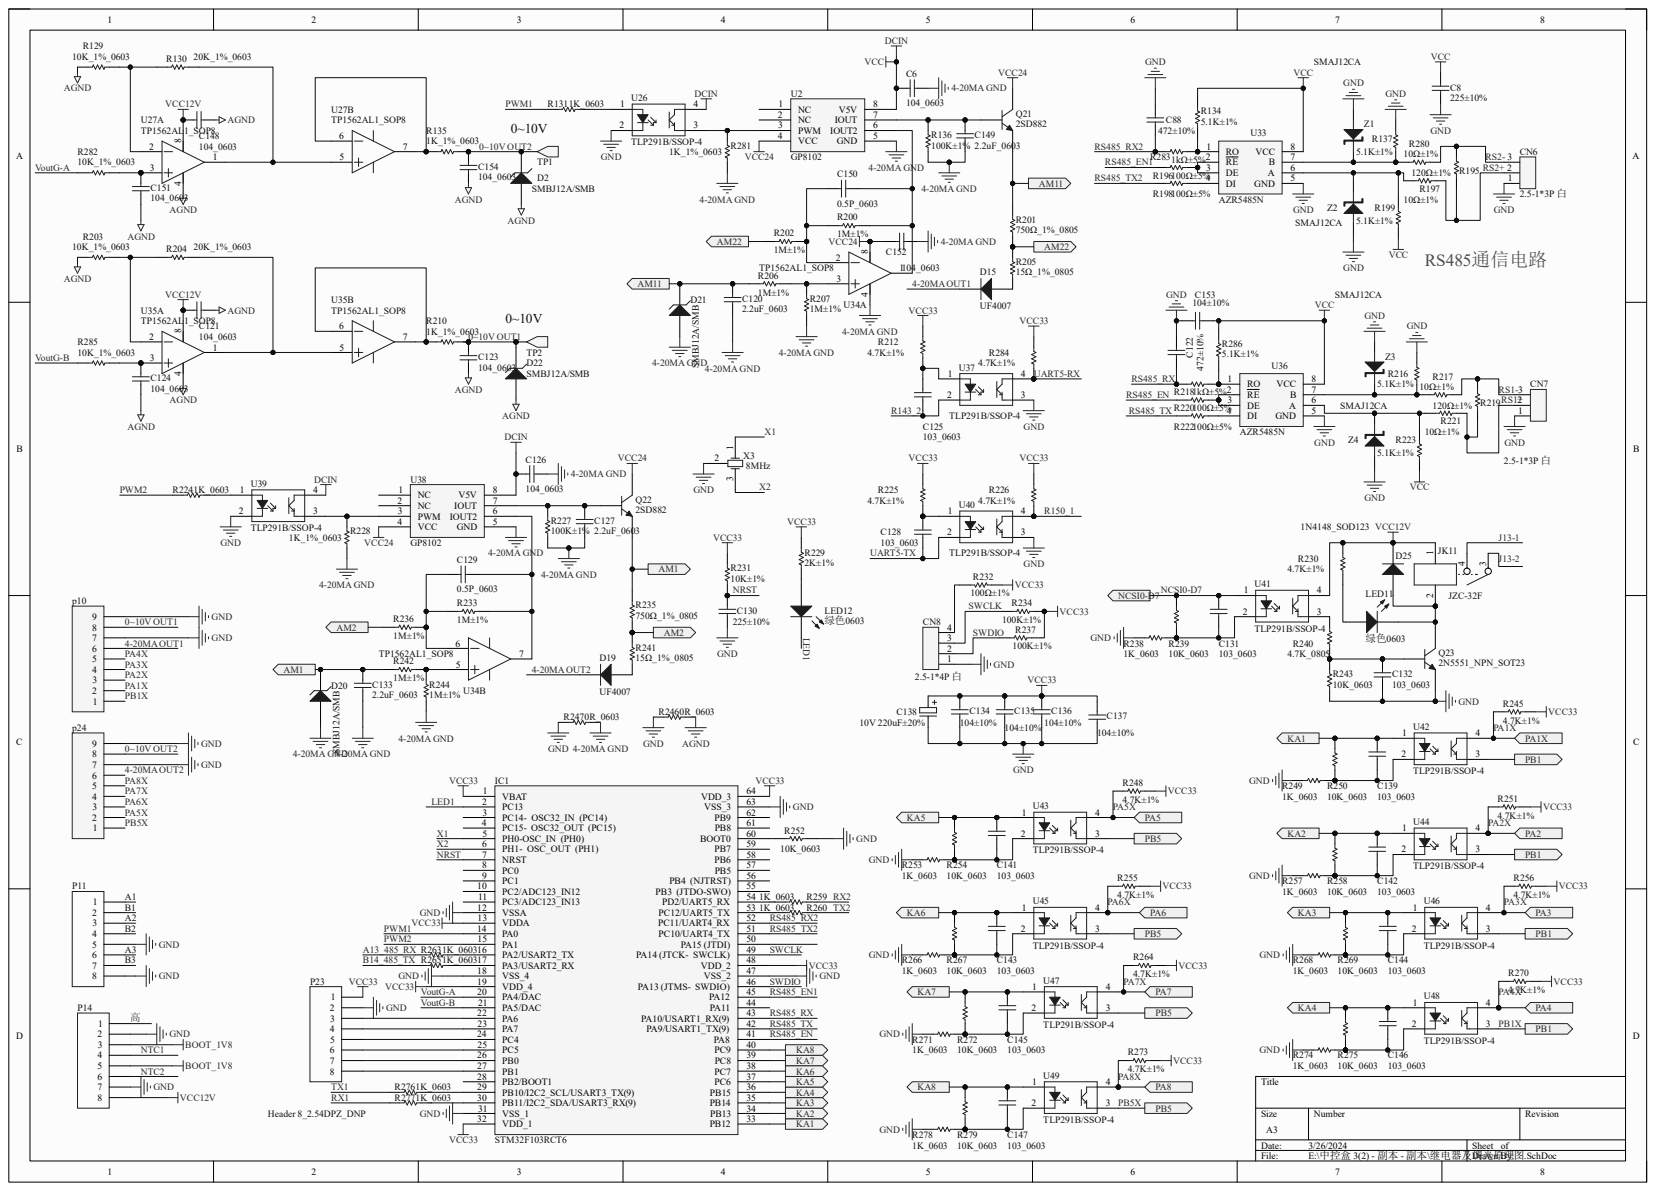
[picture p57: page 5]

A A

R181

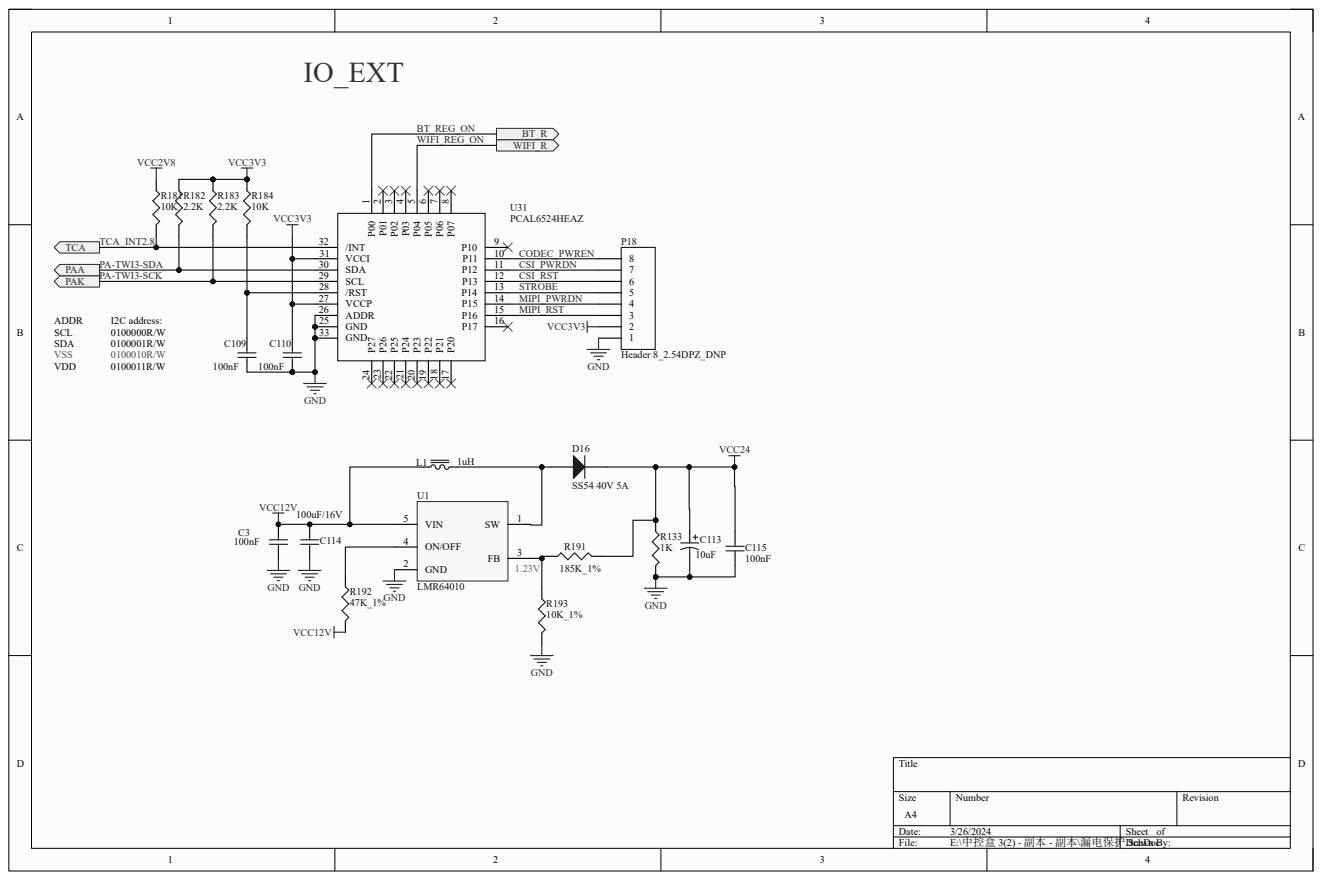
[picture p58: page 6]

# Gigabit Ethernet

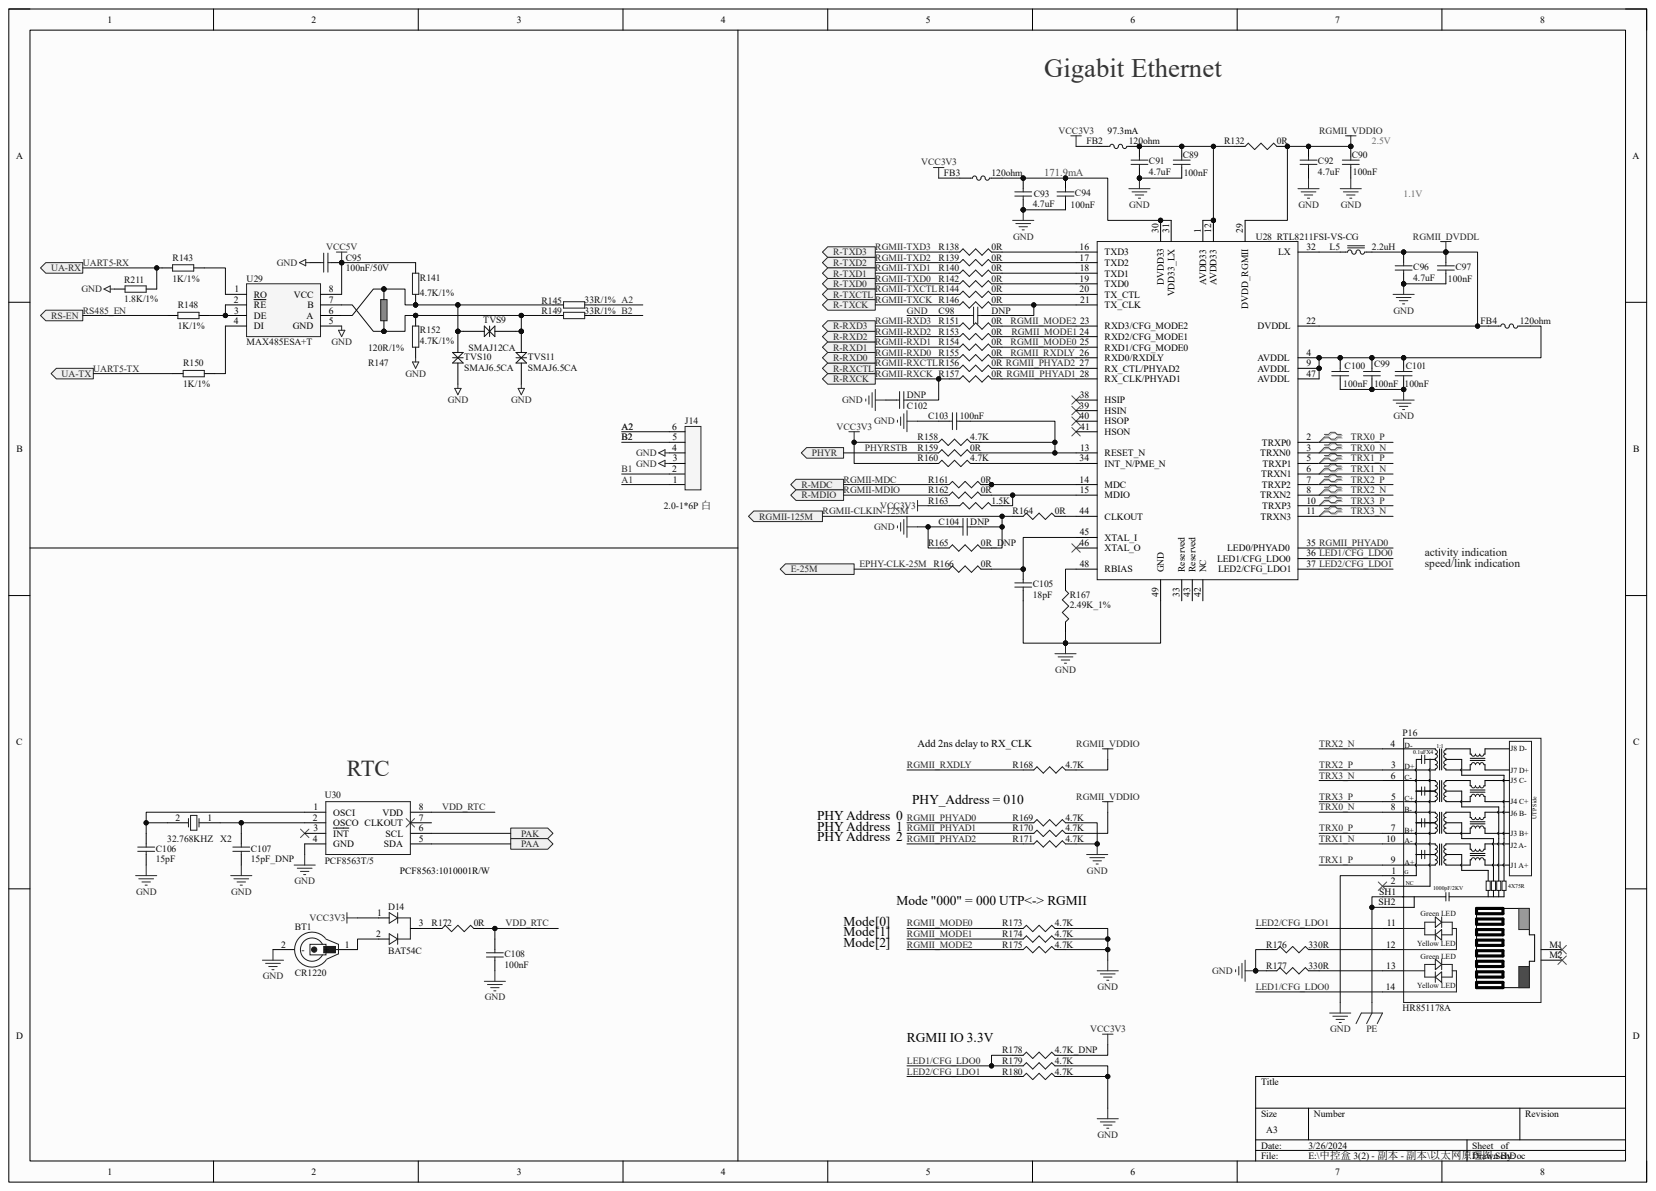
[picture p59: page 7]

D D

C C

B B

A A

### 总原理图 IMT-2CP1-AC220-STM32F103.SchDoc

### 总原理图 电源原理图.SchDoc

### 总原理图 BN模块.SchDoc

### 总原理图 以太网原理图.SchDoc

### 总原理图 计量原理图.SchDoc

### 总原理图

继电器及调光原理图.SchDoc | 总原理图
| 漏电保护.SchDoc
