Marksman124/center_control/原理图/LED.pdf

1 | 2 | 3 | 4 | 5 | DWG NO: | REV: | 6

### VCC3V3

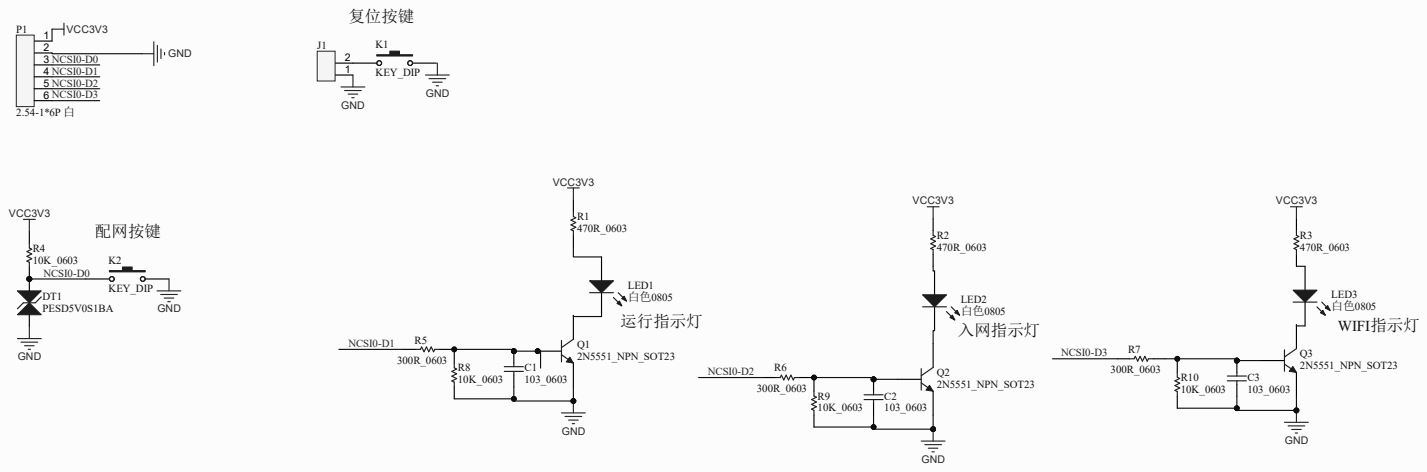
[picture p60: page 1]

THIS DOCUMENT AND THE DATA DISCLOSED HEREIN OR HEREWITH IS THE PROPERTY OF ALTIUM LIMITED AND MAY BE FREELY DISTRIBUTED IN WHOLE. NO RIGHTS ARE RESERVED OR EXPRESS OR IMPLIED WARANTEE GIVEN. | VCC3V3 | REVISION | DESCRIPTION | DATE | APPROVED

APPROVALS | DATE | PROJECT | * *

ENG: *
DSN: * | | PROJECT REVISION: | DOCUMENT REVISION: Not in version control | DESIGN ITEM: Not in version control
CHK: *
