Marksman124/center_control/(list of files, drawings)

Other design files:
资料/IM3332三相电能计量模块资料包V1.3/IM3332.PcbLib
资料/IM3332三相电能计量模块资料包V1.3/IM3332.SchLib
