Marksman124/center_control/center_control_app/Core/Src/main.c

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
/* Includes ------------------------------------------------------------------*/
#include "main.h"
#include "cmsis_os.h"
#include "crc.h"
#include "dac.h"
#include "dma.h"
#include "iwdg.h"
#include "tim.h"
#include "usart.h"
#include "gpio.h"

/* USER CODE BEGIN Includes */
//#include "modbus.h"
/* USER CODE END Includes */

/* USER CODE BEGIN PD */
extern void prvvTIMERExpiredISR( void );
/* USER CODE END PD */


void SystemClock_Config(void);
void MX_FREERTOS_Init(void);
/* USER CODE BEGIN PFP */

extern void Modbus_Buffer_Init(void);
extern void Dev_Information_Init(void);

/* USER CODE END PFP */

/**
  * @brief  The application entry point.
  * @retval int
  */
int main(void)
{
  /* USER CODE BEGIN 1 */
	SCB->VTOR = FLASH_BASE | 0x8000;
	__enable_irq();
	HAL_DeInit();
	
  /* USER CODE END 1 */

  /* MCU Configuration--------------------------------------------------------*/

  /* Reset of all peripherals, Initializes the Flash interface and the Systick. */
  HAL_Init();

  /* Configure the system clock */
  SystemClock_Config();

  /* USER CODE BEGIN SysInit */
	Modbus_Buffer_Init();
	Dev_Information_Init();

  /* USER CODE END SysInit */

  /* Initialize all configured peripherals */
  MX_GPIO_Init();
  MX_DMA_Init();
  MX_USART1_UART_Init();
  MX_DAC_Init();
  MX_TIM2_Init();
  MX_UART4_Init();
  MX_UART5_Init();
  MX_USART2_UART_Init();
  MX_USART3_UART_Init();
  MX_TIM4_Init();
  MX_TIM5_Init();
  MX_CRC_Init();
  MX_TIM3_Init();
  MX_IWDG_Init();
  /* Call init function for freertos objects (in freertos.c) */
  MX_FREERTOS_Init();

  /* Start scheduler */
  osKernelStart();

  /* We should never get here as control is now taken by the scheduler */
  /* Infinite loop */
  /* USER CODE BEGIN WHILE */
  while (1)
  {
    /* USER CODE END WHILE */

    /* USER CODE BEGIN 3 */
//		HAL_WWDG_Refresh(&hwwdg);
  }
  /* USER CODE END 3 */
}

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
/* USER CODE BEGIN 4 */
//void HAL_UART_RxCpltCallback(UART_HandleTypeDef *huart)
//{
//	uint16_t crc_value=0;
//  /* Prevent unused argument(s) compilation warning */
//  UNUSED(huart);
//  /* NOTE: This function Should not be modified, when the callback is needed,
//	the HAL_UART_TxCpltCallback could be implemented in the user file*/
//	if(Uart1_Rx_Cnt >= 255)  //溢出判断
//	{
//		Uart1_Rx_Cnt = 0;
//		memset(Uart1_RxBuff,0x00,sizeof(Uart1_RxBuff));
//		HAL_UART_Transmit(&huart1, (uint8_t *)&cAlmStr, sizeof(cAlmStr),0xFFFF);
//	}
//	else
//	{
//		Uart1_RxBuff[Uart1_Rx_Cnt++] = aRxBuffer;   //接收数据转存
//		// HAL_CRC_Calculate() 函数在每次计算时，对DR寄存器进行了复位，而HAL_CRC_Accumulate() 函数没有，因此在使用时就要根据需求来选择相应的函数了。
//		crc_value = HAL_CRC_Calculate(&hcrc, (uint32_t *)Uart1_RxBuff, Uart1_Rx_Cnt-2);
//		if((Uart1_RxBuff[Uart1_Rx_Cnt-1] == (crc_value&0xff))&&(Uart1_RxBuff[Uart1_Rx_Cnt-2] == ((crc_value>>8)&0xff))) //crc校验
//		{			
//			HAL_UART_Transmit(&huart1, (uint8_t *)&Uart1_RxBuff, Uart1_Rx_Cnt,0xFFFF); //将收到的信息发送出去
//			Uart1_Rx_Cnt = 0;
//			memset(Uart1_RxBuff,0x00,sizeof(Uart1_RxBuff)); //清空数组
//		}
//	}
//	HAL_UART_Receive_IT(&huart1, (uint8_t *)&aRxBuffer, 1);   //再开启接收中断
//}
/* USER CODE END 4 */

/**
  * @brief  Period elapsed callback in non blocking mode
  * @note   This function is called  when TIM1 interrupt took place, inside
  * HAL_TIM_IRQHandler(). It makes a direct call to HAL_IncTick() to increment
  * a global variable "uwTick" used as application time base.
  * @param  htim : TIM handle
  * @retval None
  */
void HAL_TIM_PeriodElapsedCallback(TIM_HandleTypeDef *htim)
{
  if (htim->Instance == TIM1) {
    HAL_IncTick();
  }
  /* USER CODE BEGIN Callback 1 */
	if (htim->Instance == TIM4) {
    prvvTIMERExpiredISR();
  }
  /* USER CODE END Callback 1 */
}

/**
  * @brief  This function is executed in case of error occurrence.
  * @retval None
  */
void Error_Handler(void)
{
  /* USER CODE BEGIN Error_Handler_Debug */
  /* User can add his own implementation to report the HAL error return state */
  __disable_irq();
  while (1)
  {
  }
  /* USER CODE END Error_Handler_Debug */
}

#ifdef  USE_FULL_ASSERT
/**
  * @brief  Reports the name of the source file and the source line number
  *         where the assert_param error has occurred.
  * @param  file: pointer to the source file name
  * @param  line: assert_param error line source number
  * @retval None
  */
void assert_failed(uint8_t *file, uint32_t line)
{
  /* USER CODE BEGIN 6 */
  /* User can add his own implementation to report the file name and line number,
     ex: printf("Wrong parameters value: file %s on line %d\r\n", file, line) */
  /* USER CODE END 6 */
}
#endif /* USE_FULL_ASSERT */
