Marksman124/center_control/center_control_app/center_control_app.ioc

Mcu.UserName=STM32F103RCTx
PA0-WKUP.Signal=S_TIM2_CH1_ETR
PA1.Signal=S_TIM2_CH2
PA10.Signal=USART1_RX
PA12.GPIO_Label=RS48504_RE
PA12.Signal=GPIO_Output
PA13.Signal=SYS_JTMS-SWDIO
PA14.Signal=SYS_JTCK-SWCLK
PA15.Signal=SYS_JTDI
PA2.Signal=USART2_TX
PA3.Signal=USART2_RX
PA4.Signal=COMP_DAC1_group
PA5.Signal=COMP_DAC2_group
PA6.Signal=GPIO_Output
PA7.Signal=GPIO_Output
PA8.GPIO_Label=RS48501_RE
PA8.Signal=GPIO_Output
PA9.Signal=USART1_TX
PB0.Signal=GPIO_Output
PB1.Signal=GPIO_Output
PB10.Signal=USART3_TX
PB11.Signal=USART3_RX
PB12.Signal=GPIO_Output
PB13.Signal=GPIO_Output
PB14.Signal=GPIO_Output
PB15.Signal=GPIO_Output
PB3.Signal=SYS_JTDO-TRACESWO
PB4.Signal=SYS_NJTRST
PC10.Signal=UART4_TX
PC11.Signal=UART4_RX
PC12.Signal=UART5_TX
PC13-TAMPER-RTC.Signal=GPIO_Output
PC14-OSC32_IN.Signal=RCC_OSC32_IN
PC15-OSC32_OUT.Signal=RCC_OSC32_OUT
PC4.Signal=GPIO_Output
PC5.Signal=GPIO_Output
PC6.Signal=GPIO_Output
PC7.Signal=GPIO_Output
PC8.Signal=GPIO_Output
PC9.Signal=GPIO_Output
PD0-OSC_IN.Signal=RCC_OSC_IN
PD1-OSC_OUT.Signal=RCC_OSC_OUT
PD2.Signal=UART5_RX
