Marksman124/center_control/center_control_app/Core/Inc/main.h

#define MODBUS_USART								2		//2  //(A3)  3备用
#define THREAD_PERIOD_MODBUS_USART								10
#define THREAD_PERIOD_MAIN_PUMP_TASK							10
#define RS48501_RE_Pin GPIO_PIN_8
#define RS48501_RE_GPIO_Port GPIOA
#define RS48504_RE_Pin GPIO_PIN_12
#define RS48504_RE_GPIO_Port GPIOA
