Marksman124/center_control/center_control_app/Core/Src/usart.c

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
/* Includes ------------------------------------------------------------------*/
#include "usart.h"

/* USER CODE BEGIN 0 */
#include <string.h>
#include "subsystem.h"
#include "dev.h"
#include "debug_protocol.h"	///////////////////////	串口调试

//串口1中断服务程序
//注意,读取USARTx->SR能避免莫名其妙的错误
uint8_t USART1_RX_BUF[USART_REC_LEN]; //接收缓冲,最大USART_REC_LEN个字节.
//接收状态
//bit15，	接收完成标志
//bit14，	接收到0x0d
//bit13~0，	接收到的有效字节数目
uint16_t USART1_RX_STA = 0;		 //接收状态标记
uint8_t aRxBuffer1[RXBUFFERSIZE]; //HAL库使用的串口接收缓冲
UART_HandleTypeDef huart1;	 //UART句柄

char R_speed[30];
char config_para[30];
uint8_t para_change = 0; //在线调试PID用

//串口2中断服务程序
uint8_t USART2_RX_BUF[USART_REC_LEN]; //接收缓冲,最大USART_REC_LEN个字节.
uint16_t USART2_RX_STA = 0;			 //接收状态标记
uint8_t aRxBuffer2[RXBUFFERSIZE];	 //HAL库使用的串口接收缓冲
UART_HandleTypeDef huart2;		 //UART句柄

//串口3
uint8_t USART3_RX_BUF[USART_REC_LEN]; //接收缓冲,最大USART_REC_LEN个字节.末字节为换行符
uint16_t USART3_RX_STA;				 //接收状态标记
UART_HandleTypeDef huart3;		 //UART句柄
uint8_t aRxBuffer3[RXBUFFERSIZE];	 //HAL库USART接收Buffer

//串口4
uint8_t USART4_RX_BUF[USART_REC_LEN]; //接收缓冲,最大USART_REC_LEN个字节.末字节为换行符
uint16_t USART4_RX_STA;				 //接收状态标记
UART_HandleTypeDef huart4;		 //UART句柄
uint8_t aRxBuffer4[RXBUFFERSIZE];	 //HAL库USART接收Buffer

//串口5
uint8_t USART5_RX_BUF[USART_REC_LEN]; //接收缓冲,最大USART_REC_LEN个字节.末字节为换行符
uint16_t USART5_RX_STA;				 //接收状态标记
UART_HandleTypeDef huart5;		 //UART句柄
uint8_t aRxBuffer5[RXBUFFERSIZE];	 //HAL库USART接收Buffer

uint8_t data[200];
uint8_t flag = 0;

/* USER CODE END 0 */

UART_HandleTypeDef huart4;
UART_HandleTypeDef huart5;
UART_HandleTypeDef huart1;
UART_HandleTypeDef huart2;
UART_HandleTypeDef huart3;
DMA_HandleTypeDef hdma_uart4_rx;
DMA_HandleTypeDef hdma_usart1_rx;

/* UART4 init function */
void MX_UART4_Init(void)
{

  /* USER CODE BEGIN UART4_Init 0 */
	uint32_t baud_rate=0,stop_bits=0;
	baud_rate = Dev_BaudRate_Get(4);
#if (DMX512_HUART == 4)
	stop_bits = UART_STOPBITS_2;
#else
	stop_bits = UART_STOPBITS_1;
#endif
  /* USER CODE END UART4_Init 0 */

  huart4.Instance = UART4;
  huart4.Init.BaudRate = baud_rate;
  huart4.Init.WordLength = UART_WORDLENGTH_8B;
  huart4.Init.StopBits = stop_bits;
  huart4.Init.Parity = UART_PARITY_NONE;
  huart4.Init.Mode = UART_MODE_TX_RX;
  huart4.Init.HwFlowCtl = UART_HWCONTROL_NONE;
  huart4.Init.OverSampling = UART_OVERSAMPLING_16;
  if (HAL_UART_Init(&huart4) != HAL_OK)
  {
    Error_Handler();
  }
}
/* UART5 init function */
void MX_UART5_Init(void)
{

  /* USER CODE BEGIN UART5_Init 0 */
	uint32_t baud_rate=0;
	baud_rate = Dev_BaudRate_Get(5);
  /* USER CODE END UART5_Init 0 */

  huart5.Instance = UART5;
  huart5.Init.BaudRate = baud_rate;
  huart5.Init.WordLength = UART_WORDLENGTH_8B;
  huart5.Init.StopBits = UART_STOPBITS_1;
  huart5.Init.Parity = UART_PARITY_NONE;
  huart5.Init.Mode = UART_MODE_TX_RX;
  huart5.Init.HwFlowCtl = UART_HWCONTROL_NONE;
  huart5.Init.OverSampling = UART_OVERSAMPLING_16;
  if (HAL_UART_Init(&huart5) != HAL_OK)
  {
    Error_Handler();
  }
  /* USER CODE BEGIN UART5_Init 2 */
	HAL_UART_Receive_IT(&huart5, (uint8_t *)aRxBuffer5, RXBUFFERSIZE); //该函数会开启接收中断：标志位UART_IT_RXNE，并且设置接收缓冲以及接收缓冲接收最大数据量
	
  /* USER CODE END UART5_Init 2 */

}
/* USART1 init function */

void MX_USART1_UART_Init(void)
{

  /* USER CODE BEGIN USART1_Init 0 */
	uint32_t baud_rate=0,stop_bits=0;
	baud_rate = Dev_BaudRate_Get(1);
#if (DMX512_HUART == 1)
	stop_bits = UART_STOPBITS_2;
#else
	stop_bits = UART_STOPBITS_1;
#endif
  /* USER CODE END USART1_Init 0 */

  huart1.Instance = USART1;
  huart1.Init.BaudRate = baud_rate;
  huart1.Init.WordLength = UART_WORDLENGTH_8B;
  huart1.Init.StopBits = stop_bits;
  huart1.Init.Parity = UART_PARITY_NONE;
  huart1.Init.Mode = UART_MODE_TX_RX;
  huart1.Init.HwFlowCtl = UART_HWCONTROL_NONE;
  huart1.Init.OverSampling = UART_OVERSAMPLING_16;
  if (HAL_UART_Init(&huart1) != HAL_OK)
  {
    Error_Handler();
  }
}
/* USART2 init function */

void MX_USART2_UART_Init(void)
{

  /* USER CODE BEGIN USART2_Init 0 */
	uint32_t baud_rate=0;
	baud_rate = Dev_BaudRate_Get(2);
  /* USER CODE END USART2_Init 0 */

  huart2.Instance = USART2;
  huart2.Init.BaudRate = baud_rate;
  huart2.Init.WordLength = UART_WORDLENGTH_8B;
  huart2.Init.StopBits = UART_STOPBITS_1;
  huart2.Init.Parity = UART_PARITY_NONE;
  huart2.Init.Mode = UART_MODE_TX_RX;
  huart2.Init.HwFlowCtl = UART_HWCONTROL_NONE;
  huart2.Init.OverSampling = UART_OVERSAMPLING_16;
  if (HAL_UART_Init(&huart2) != HAL_OK)
  {
    Error_Handler();
  }
}
/* USART3 init function */

void MX_USART3_UART_Init(void)
{

  /* USER CODE BEGIN USART3_Init 0 */
	uint32_t baud_rate=0;
	baud_rate = Dev_BaudRate_Get(3);
  /* USER CODE END USART3_Init 0 */

  huart3.Instance = USART3;
  huart3.Init.BaudRate = baud_rate;
  huart3.Init.WordLength = UART_WORDLENGTH_8B;
  huart3.Init.StopBits = UART_STOPBITS_1;
  huart3.Init.Parity = UART_PARITY_NONE;
  huart3.Init.Mode = UART_MODE_TX_RX;
  huart3.Init.HwFlowCtl = UART_HWCONTROL_NONE;
  huart3.Init.OverSampling = UART_OVERSAMPLING_16;
  if (HAL_UART_Init(&huart3) != HAL_OK)
  {
    Error_Handler();
  }
  /* USER CODE BEGIN USART3_Init 2 */
#ifdef DEBUG_HUART
	HAL_UART_Receive_IT(&huart3, (uint8_t *)aRxBuffer3, RXBUFFERSIZE); //该函数会开启接收中断：标志位UART_IT_RXNE，并且设置接收缓冲以及接收缓冲接收最大数据量
#endif
  /* USER CODE END USART3_Init 2 */

}

void HAL_UART_MspInit(UART_HandleTypeDef* uartHandle)
{

  GPIO_InitTypeDef GPIO_InitStruct = {0};
  if(uartHandle->Instance==UART4)
  {
    /* UART4 clock enable */
    __HAL_RCC_UART4_CLK_ENABLE();

    __HAL_RCC_GPIOC_CLK_ENABLE();
    /**UART4 GPIO Configuration
    PC10     ------> UART4_TX
    PC11     ------> UART4_RX
    */
    GPIO_InitStruct.Pin = GPIO_PIN_10;
    GPIO_InitStruct.Mode = GPIO_MODE_AF_PP;
    GPIO_InitStruct.Speed = GPIO_SPEED_FREQ_HIGH;
    HAL_GPIO_Init(GPIOC, &GPIO_InitStruct);

    GPIO_InitStruct.Pin = GPIO_PIN_11;
    GPIO_InitStruct.Mode = GPIO_MODE_INPUT;
    GPIO_InitStruct.Pull = GPIO_NOPULL;
    HAL_GPIO_Init(GPIOC, &GPIO_InitStruct);

    /* UART4 DMA Init */
    /* UART4_RX Init */
    hdma_uart4_rx.Instance = DMA2_Channel3;
    hdma_uart4_rx.Init.Direction = DMA_PERIPH_TO_MEMORY;
    hdma_uart4_rx.Init.PeriphInc = DMA_PINC_DISABLE;
    hdma_uart4_rx.Init.MemInc = DMA_MINC_ENABLE;
    hdma_uart4_rx.Init.PeriphDataAlignment = DMA_PDATAALIGN_BYTE;
    hdma_uart4_rx.Init.MemDataAlignment = DMA_MDATAALIGN_BYTE;
    hdma_uart4_rx.Init.Mode = DMA_NORMAL;
    hdma_uart4_rx.Init.Priority = DMA_PRIORITY_LOW;
    if (HAL_DMA_Init(&hdma_uart4_rx) != HAL_OK)
    {
      Error_Handler();
    }

    __HAL_LINKDMA(uartHandle,hdmarx,hdma_uart4_rx);

    /* UART4 interrupt Init */
    HAL_NVIC_SetPriority(UART4_IRQn, 6, 0);
    HAL_NVIC_EnableIRQ(UART4_IRQn);
  }
  else if(uartHandle->Instance==UART5)
  {
    /* UART5 clock enable */
    __HAL_RCC_UART5_CLK_ENABLE();

    __HAL_RCC_GPIOC_CLK_ENABLE();
    __HAL_RCC_GPIOD_CLK_ENABLE();
    /**UART5 GPIO Configuration
    PC12     ------> UART5_TX
    PD2     ------> UART5_RX
    */
    GPIO_InitStruct.Pin = GPIO_PIN_12;
    GPIO_InitStruct.Mode = GPIO_MODE_AF_PP;
    GPIO_InitStruct.Speed = GPIO_SPEED_FREQ_HIGH;
    HAL_GPIO_Init(GPIOC, &GPIO_InitStruct);

    GPIO_InitStruct.Pin = GPIO_PIN_2;
    GPIO_InitStruct.Mode = GPIO_MODE_INPUT;
    GPIO_InitStruct.Pull = GPIO_NOPULL;
    HAL_GPIO_Init(GPIOD, &GPIO_InitStruct);

    /* UART5 interrupt Init */
    HAL_NVIC_SetPriority(UART5_IRQn, 5, 0);
    HAL_NVIC_EnableIRQ(UART5_IRQn);
  }
  else if(uartHandle->Instance==USART1)
  {
    /* USART1 clock enable */
    __HAL_RCC_USART1_CLK_ENABLE();

    __HAL_RCC_GPIOA_CLK_ENABLE();
    /**USART1 GPIO Configuration
    PA9     ------> USART1_TX
    PA10     ------> USART1_RX
    */
    GPIO_InitStruct.Pin = GPIO_PIN_9;
    GPIO_InitStruct.Mode = GPIO_MODE_AF_PP;
    GPIO_InitStruct.Speed = GPIO_SPEED_FREQ_HIGH;
    HAL_GPIO_Init(GPIOA, &GPIO_InitStruct);

    GPIO_InitStruct.Pin = GPIO_PIN_10;
    GPIO_InitStruct.Mode = GPIO_MODE_INPUT;
    GPIO_InitStruct.Pull = GPIO_NOPULL;
    HAL_GPIO_Init(GPIOA, &GPIO_InitStruct);

    /* USART1 DMA Init */
    /* USART1_RX Init */
    hdma_usart1_rx.Instance = DMA1_Channel5;
    hdma_usart1_rx.Init.Direction = DMA_PERIPH_TO_MEMORY;
    hdma_usart1_rx.Init.PeriphInc = DMA_PINC_DISABLE;
    hdma_usart1_rx.Init.MemInc = DMA_MINC_ENABLE;
    hdma_usart1_rx.Init.PeriphDataAlignment = DMA_PDATAALIGN_BYTE;
    hdma_usart1_rx.Init.MemDataAlignment = DMA_MDATAALIGN_BYTE;
    hdma_usart1_rx.Init.Mode = DMA_NORMAL;
    hdma_usart1_rx.Init.Priority = DMA_PRIORITY_LOW;
    if (HAL_DMA_Init(&hdma_usart1_rx) != HAL_OK)
    {
      Error_Handler();
    }

    __HAL_LINKDMA(uartHandle,hdmarx,hdma_usart1_rx);

    /* USART1 interrupt Init */
    HAL_NVIC_SetPriority(USART1_IRQn, 6, 0);
    HAL_NVIC_EnableIRQ(USART1_IRQn);
  }
  else if(uartHandle->Instance==USART2)
  {
    /* USART2 clock enable */
    __HAL_RCC_USART2_CLK_ENABLE();

    __HAL_RCC_GPIOA_CLK_ENABLE();
    /**USART2 GPIO Configuration
    PA2     ------> USART2_TX
    PA3     ------> USART2_RX
    */
    GPIO_InitStruct.Pin = GPIO_PIN_2;
    GPIO_InitStruct.Mode = GPIO_MODE_AF_PP;
    GPIO_InitStruct.Speed = GPIO_SPEED_FREQ_HIGH;
    HAL_GPIO_Init(GPIOA, &GPIO_InitStruct);

    GPIO_InitStruct.Pin = GPIO_PIN_3;
    GPIO_InitStruct.Mode = GPIO_MODE_INPUT;
    GPIO_InitStruct.Pull = GPIO_NOPULL;
    HAL_GPIO_Init(GPIOA, &GPIO_InitStruct);

    /* USART2 interrupt Init */
    HAL_NVIC_SetPriority(USART2_IRQn, 5, 0);
    HAL_NVIC_EnableIRQ(USART2_IRQn);
  }
  else if(uartHandle->Instance==USART3)
  {
    /* USART3 clock enable */
    __HAL_RCC_USART3_CLK_ENABLE();

    __HAL_RCC_GPIOB_CLK_ENABLE();
    /**USART3 GPIO Configuration
    PB10     ------> USART3_TX
    PB11     ------> USART3_RX
    */
    GPIO_InitStruct.Pin = GPIO_PIN_10;
    GPIO_InitStruct.Mode = GPIO_MODE_AF_PP;
    GPIO_InitStruct.Speed = GPIO_SPEED_FREQ_HIGH;
    HAL_GPIO_Init(GPIOB, &GPIO_InitStruct);

    GPIO_InitStruct.Pin = GPIO_PIN_11;
    GPIO_InitStruct.Mode = GPIO_MODE_INPUT;
    GPIO_InitStruct.Pull = GPIO_NOPULL;
    HAL_GPIO_Init(GPIOB, &GPIO_InitStruct);

    /* USART3 interrupt Init */
    HAL_NVIC_SetPriority(USART3_IRQn, 15, 0);
    HAL_NVIC_EnableIRQ(USART3_IRQn);
  }
}

void HAL_UART_MspDeInit(UART_HandleTypeDef* uartHandle)
{

  if(uartHandle->Instance==UART4)
  {
    /* Peripheral clock disable */
    __HAL_RCC_UART4_CLK_DISABLE();

    /**UART4 GPIO Configuration
    PC10     ------> UART4_TX
    PC11     ------> UART4_RX
    */
    HAL_GPIO_DeInit(GPIOC, GPIO_PIN_10|GPIO_PIN_11);

    /* UART4 DMA DeInit */
    HAL_DMA_DeInit(uartHandle->hdmarx);

    /* UART4 interrupt Deinit */
    HAL_NVIC_DisableIRQ(UART4_IRQn);
  }
  else if(uartHandle->Instance==UART5)
  {
    /* Peripheral clock disable */
    __HAL_RCC_UART5_CLK_DISABLE();

    /**UART5 GPIO Configuration
    PC12     ------> UART5_TX
    PD2     ------> UART5_RX
    */
    HAL_GPIO_DeInit(GPIOC, GPIO_PIN_12);

    HAL_GPIO_DeInit(GPIOD, GPIO_PIN_2);

    /* UART5 interrupt Deinit */
    HAL_NVIC_DisableIRQ(UART5_IRQn);
  }
  else if(uartHandle->Instance==USART1)
  {
    /* Peripheral clock disable */
    __HAL_RCC_USART1_CLK_DISABLE();

    /**USART1 GPIO Configuration
    PA9     ------> USART1_TX
    PA10     ------> USART1_RX
    */
    HAL_GPIO_DeInit(GPIOA, GPIO_PIN_9|GPIO_PIN_10);

    /* USART1 DMA DeInit */
    HAL_DMA_DeInit(uartHandle->hdmarx);

    /* USART1 interrupt Deinit */
    HAL_NVIC_DisableIRQ(USART1_IRQn);
  }
  else if(uartHandle->Instance==USART2)
  {
    /* Peripheral clock disable */
    __HAL_RCC_USART2_CLK_DISABLE();

    /**USART2 GPIO Configuration
    PA2     ------> USART2_TX
    PA3     ------> USART2_RX
    */
    HAL_GPIO_DeInit(GPIOA, GPIO_PIN_2|GPIO_PIN_3);

    /* USART2 interrupt Deinit */
    HAL_NVIC_DisableIRQ(USART2_IRQn);
  }
  else if(uartHandle->Instance==USART3)
  {
    /* Peripheral clock disable */
    __HAL_RCC_USART3_CLK_DISABLE();

    /**USART3 GPIO Configuration
    PB10     ------> USART3_TX
    PB11     ------> USART3_RX
    */
    HAL_GPIO_DeInit(GPIOB, GPIO_PIN_10|GPIO_PIN_11);

    /* USART3 interrupt Deinit */
    HAL_NVIC_DisableIRQ(USART3_IRQn);
  }
}

/* USER CODE BEGIN 1 */

void HAL_UART_RxCpltCallback(UART_HandleTypeDef *huart)
{
	if (huart->Instance == USART1) //如果是串口1
	{
		
	}
	if (huart->Instance == USART2) //如果是串口2
	{
		if ((USART2_RX_STA & 0x8000) == 0) //接收未完成
		{
			if (USART2_RX_STA & 0x4000) //接收到了0x0d
			{
				if (aRxBuffer2[0] != 0x0a)
					USART2_RX_STA = 0; //接收错误,重新开始
				else
					USART2_RX_STA |= 0x8000; //接收完成了
			}
			else //还没收到0X0D
			{
				if (aRxBuffer2[0] == 0x0d)
					USART2_RX_STA |= 0x4000;
				else
				{
					USART2_RX_BUF[USART2_RX_STA & 0X3FFF] = aRxBuffer2[0];
					USART2_RX_STA++;
					if (USART2_RX_STA > (USART_REC_LEN - 1))
						USART2_RX_STA = 0; //接收数据错误,重新开始接收
				}
			}
		}

		if (USART2_RX_STA & 0x8000)
		{
			flag = 1;
			memcpy(data, USART2_RX_BUF, USART2_RX_STA & 0x3fff);
			USART2_RX_STA = 0;
		}
	}

	if (huart->Instance == USART3) //如果是串口3
	{
		if ((USART3_RX_STA & 0x8000) == 0) //接收未完成
		{
			if (USART3_RX_STA & 0x4000) //接收到了0x0d
			{
				if (aRxBuffer3[0] != 0x0a)
					USART3_RX_STA = 0; //接收错误,重新开始
				else
					USART3_RX_STA |= 0x8000; //接收完成了
			}
			else //还没收到0X0D
			{
				if (aRxBuffer3[0] == 0x0d)
					USART3_RX_STA |= 0x4000;
				else
				{
					USART3_RX_BUF[USART3_RX_STA & 0X3FFF] = aRxBuffer3[0];
					USART3_RX_STA++;
					if (USART3_RX_STA > (USART_REC_LEN - 1))
						USART3_RX_STA = 0; //接收数据错误,重新开始接收
				}
			}
		}

		if (USART3_RX_STA & 0x8000)
		{
			flag = 1;
			To_Debug_Protocol_Analysis(USART3_RX_BUF, USART3_RX_STA & 0x3fff);
			memset(USART3_RX_BUF, 0, USART3_RX_STA & 0x3fff);
			USART3_RX_STA = 0;
		}
	}

	if (huart->Instance == UART4) //如果是串口4
	{
		if ((USART4_RX_STA & 0x8000) == 0) //接收未完成
		{
			if (USART4_RX_STA & 0x4000) //接收到了0x0d
			{
				if (aRxBuffer4[0] != 0x0a)
					USART4_RX_STA = 0; //接收错误,重新开始
				else
					USART4_RX_STA |= 0x8000; //接收完成了
			}
			else //还没收到0X0D
			{
				if (aRxBuffer4[0] == 0x0d)
					USART4_RX_STA |= 0x4000;
				else
				{
					USART4_RX_BUF[USART4_RX_STA & 0X3FFF] = aRxBuffer4[0];
					USART4_RX_STA++;
					if (USART4_RX_STA > (USART_REC_LEN - 1))
						USART4_RX_STA = 0; //接收数据错误,重新开始接收
				}
			}
		}

		if (USART4_RX_STA & 0x8000)
		{
			flag = 1;
			memcpy(data, USART4_RX_BUF, USART4_RX_STA & 0x3fff);
			USART4_RX_STA = 0;
		}
	}

	if (huart->Instance == UART5) //如果是串口5
	{
		if ((USART5_RX_STA & 0x8000) == 0) //接收未完成
		{
			if (USART5_RX_STA & 0x4000) //接收到了0x0d
			{
				if (aRxBuffer5[0] != 0x0a)
					USART5_RX_STA = 0; //接收错误,重新开始
				else
					USART5_RX_STA |= 0x8000; //接收完成了
			}
			else //还没收到0X0D
			{
				if (aRxBuffer5[0] == 0x0d)
					USART5_RX_STA |= 0x4000;
				else
				{
					USART5_RX_BUF[USART5_RX_STA & 0X3FFF] = aRxBuffer5[0];
					USART5_RX_STA++;
					if (USART5_RX_STA > (USART_REC_LEN - 1))
						USART5_RX_STA = 0; //接收数据错误,重新开始接收
				}
			}
		}

		if (USART5_RX_STA & 0x8000)
		{
			flag = 1;
			To_Debug_Protocol_Analysis(USART5_RX_BUF, USART5_RX_STA & 0x3fff);
			memset(USART5_RX_BUF, 0, USART5_RX_STA & 0x3fff);
			USART5_RX_STA = 0;
		}
	}
}

/* USER CODE END 1 */
