Marksman124/center_control/center_control_app/Core/app/modbus.c

/**
******************************************************************************
* @file    		modbus.c
* @brief   		Modbus 接口
*
*
* @author			WQG
* @versions   v1.0
* @date   		2024-1-5
******************************************************************************
*/
/* Includes ------------------------------------------------------------------*/
#include "modbus.h"
#include "dev.h"
/* ----------------------- Defines ------------------------------------------*/
// 03
#define REG_HOLDING_START               ( 1 )
#define REG_HOLDING_NREGS               ( 0x013F )

// 04
#define REG_INPUT_START 								( 1 )
#define REG_INPUT_NREGS 								( 0x003F )

// 21
#define REG_FILE_NUMBER_MAX 								( 0x270F )
#define REG_FILE_NUMBER_STAR 								( 0 )
#define REG_FILE_NUMBER_END 								( 0xFFFF )
#define REG_FILE_LENTH_MAX 									( 0x77 )

#define MODBUS_RESTART_TIMEOUT 							( 10 )					// 100MS * N

/* Private variables ---------------------------------------------------------*/
ULONG OTA_Pack_Len=0;					// 总长度

uint32_t ModbusTimerCnt=0;



/* ----------------------- Static variables ---------------------------------*/
//USHORT   usRegHoldingStart = REG_HOLDING_START;
USHORT   usRegHoldingBuf[REG_HOLDING_NREGS+1];

//USHORT   usRegInputStart = REG_INPUT_START;
USHORT   usRegInputBuf[REG_INPUT_NREGS+1];

USHORT		MB_Data_Addr_Need_CallOut[] = {MB_DATA_ADDR_SLAVE_ADDRESS,MB_DATA_ADDR_BAUD_RATE,MB_DATA_ADDR_GEAR_PUMP_1,
MB_DATA_ADDR_GEAR_PUMP_2,MB_DATA_ADDR_CURRENT_PUMP_1,MB_DATA_ADDR_CURRENT_PUMP_2,MB_DATA_ADDR_VOLTAGE_PUMP_1,MB_DATA_ADDR_VOLTAGE_PUMP_2,
MB_DATA_ADDR_CONNECTION_MODE,MB_DATA_ADDR_METERING_MODULE_CLEAN,MB_DATA_ADDR_METERING_MODULE_ADDR, MB_DATA_ADDR_METERING_MODULE_BAUD,
MB_DATA_ADDR_METERING_MODULE_FORMAT,MB_DATA_ADDR_IO_HARDWARE_CTRL,REG_DATA_ADDR_DMX512_LENTH,REG_DATA_ADDR_DMX512_END,
};

BOOL Dmx512_Data_Change_Sign =0;
/* ----------------------- Start implementation -----------------------------*/
extern TIM_HandleTypeDef htim1;

void Clean_ModbusTimerCnt()
{
	ModbusTimerCnt = 0;
}

BOOL 
Check_Need_CallOut(USHORT addr)
{
	USHORT sum,i;
	
	sum = sizeof(MB_Data_Addr_Need_CallOut)/sizeof(MB_Data_Addr_Need_CallOut[0]);
	
	if( (addr >= REG_DATA_ADDR_DMX512_START)&& (addr <= REG_DATA_ADDR_DMX512_END) )
		Set_Dmx512_Data_Change(1);
	
	for(i=0; i<sum; i++)
	{
		if(addr == MB_Data_Addr_Need_CallOut[i])
			return TRUE;
	}
	
	return FALSE;
}

extern UART_HandleTypeDef* p_huart_mb;		 //UART句柄

void
HoldingCallOut( USHORT usAddress )
{
	uint16_t iRegIndex;
	uint32_t message_info=0;
	
	iRegIndex = ( usAddress );
	
	if( ( usAddress >= MB_DATA_ADDR_CONNECTION_MODE ) && ( usAddress <= MB_DATA_ADDR_METERING_MODULE_FORMAT ) )  // 20~24
	{
		// 下发 清零命令
		message_info = usAddress<<16 | usRegHoldingBuf[iRegIndex];
		osMessagePut(MeteringQueueHandle,message_info,1);
		if( usAddress == MB_DATA_ADDR_METERING_MODULE_CLEAN )
			usRegHoldingBuf[iRegIndex] = 0; // 写入1清零后该地址自动设置为 0 
	}
	else if(usAddress == MB_DATA_ADDR_SLAVE_ADDRESS) // 从机地址
	{
		Modbus_Init();
	}
	else if(usAddress == MB_DATA_ADDR_BAUD_RATE) // 设置波特率
	{
		__HAL_UART_DISABLE(p_huart_mb);
#if MODBUS_USART == 2
		MX_USART2_UART_Init();
#elif MODBUS_USART == 3
		MX_USART3_UART_Init();
#elif MODBUS_USART == 5
		MX_UART5_Init();
#endif
		__HAL_UART_ENABLE(p_huart_mb);
	}
	else if(usAddress == MB_DATA_ADDR_IO_HARDWARE_CTRL) // IO 控制
	{
		IO_Hardware_Ctrl_All(usRegHoldingBuf[iRegIndex]);
	}
	
	//扇区是2048， 整个 usRegHoldingBuf 一起写
	STMFLASH_Write(FLASH_APP_PARAM_ADDR, usRegHoldingBuf, REG_HOLDING_NREGS );
}


eMBErrorCode
eMBRegInputCB( UCHAR * pucRegBuffer, USHORT usAddress, USHORT usNRegs )
{
    eMBErrorCode    eStatus = MB_ENOERR;
    int             iRegIndex;

	Clean_ModbusTimerCnt();
	
    if( usAddress + usNRegs <= REG_INPUT_START + REG_INPUT_NREGS )
    {
			taskENTER_CRITICAL();
        //iRegIndex = ( int )( usAddress - usRegInputStart );
				iRegIndex = ( int )( usAddress );
        while( usNRegs > 0 )
        {
					if((iRegIndex >= REG_DATA_ADDR_DMX512_START) && (iRegIndex <= REG_DATA_ADDR_DMX512_END))//DMX 小端
					{
						*pucRegBuffer++ = ( unsigned char )( usRegInputBuf[iRegIndex] & 0xFF );
						*pucRegBuffer++ = ( unsigned char )( usRegInputBuf[iRegIndex] >> 8 );
					}
					else
					{
						*pucRegBuffer++ = ( unsigned char )( usRegInputBuf[iRegIndex] >> 8 );
						*pucRegBuffer++ = ( unsigned char )( usRegInputBuf[iRegIndex] & 0xFF );
					}
					iRegIndex++;
					usNRegs--;
        }
				taskEXIT_CRITICAL();
    }
    else
    {
        eStatus = MB_ENOREG;
    }
    return eStatus;
}

eMBErrorCode
eMBRegHoldingCB( UCHAR * pucRegBuffer, USHORT usAddress, USHORT usNRegs,
                 eMBRegisterMode eMode )
{
  eMBErrorCode    eStatus = MB_ENOERR;
    int             iRegIndex;
	
		Clean_ModbusTimerCnt();
	
    if( usAddress + usNRegs <= REG_HOLDING_START + REG_HOLDING_NREGS ) 
    {
				//iRegIndex = ( int )( usAddress - usRegHoldingStart );
        iRegIndex = ( int )( usAddress );
        switch ( eMode )
        {
        case MB_REG_READ:
					taskENTER_CRITICAL();
            while( usNRegs > 0 )
            {
							if((iRegIndex >= REG_DATA_ADDR_DMX512_START) && (iRegIndex <= REG_DATA_ADDR_DMX512_END))//DMX 小端
							{
								*pucRegBuffer++ = ( unsigned char )( usRegHoldingBuf[iRegIndex] & 0xFF );
								*pucRegBuffer++ = ( unsigned char )( usRegHoldingBuf[iRegIndex] >> 8 );
							}
							else
							{
								*pucRegBuffer++ = ( unsigned char )( usRegHoldingBuf[iRegIndex] >> 8 );
								*pucRegBuffer++ = ( unsigned char )( usRegHoldingBuf[iRegIndex] & 0xFF );
							}
              iRegIndex++;
              usNRegs--;
            }
						taskEXIT_CRITICAL();
            break;

        case MB_REG_WRITE:
					taskENTER_CRITICAL();
            while( usNRegs > 0 )
            {
							if((iRegIndex >= REG_DATA_ADDR_DMX512_START) && (iRegIndex <= REG_DATA_ADDR_DMX512_END))//DMX 小端
							{
								usRegHoldingBuf[iRegIndex] = *pucRegBuffer++;
								usRegHoldingBuf[iRegIndex] |= *pucRegBuffer++ << 8;
							}
							else
							{
								usRegHoldingBuf[iRegIndex] = *pucRegBuffer++ << 8;
								usRegHoldingBuf[iRegIndex] |= *pucRegBuffer++;
								
								if(iRegIndex == MB_DATA_ADDR_METERING_MODULE_ADDR)
								{
									if(*pucRegBuffer > METERING_ADDR_MAX)
									{
										Set_DataAddr_Value( MB_FUNC_READ_HOLDING_REGISTER,  MB_DATA_ADDR_METERING_MODULE_ADDR,  MB_METERING_ADDR_DEFAULT);
									}
								}
							}
							iRegIndex++;
              usNRegs--;
            }
						taskEXIT_CRITICAL();
						if(Check_Need_CallOut(usAddress))
						{
							HoldingCallOut(usAddress);
						}
						break;
        }
    }
    else
    {
        eStatus = MB_ENOREG;
    }
    return eStatus;
}

eMBErrorCode
eMBRegFileCB( UCHAR * pucRegBuffer, USHORT fileNumber, USHORT fileLength,
                 eMBRegisterMode eMode )
{
  eMBErrorCode    eStatus = MB_ENOERR;
	ULONG write_addr=0;						// flash 写入地址
	ULONG sign=0;
	
	Clean_ModbusTimerCnt();
	
	if( (( fileNumber <= REG_FILE_NUMBER_MAX ) || ( fileNumber == REG_FILE_NUMBER_END )) && ( fileLength <= REG_FILE_LENTH_MAX ) )
	{
		switch ( eMode )
		{
		case MB_REG_READ:
			break;
		case MB_REG_WRITE:
			if(fileNumber == REG_FILE_NUMBER_STAR) // 起始包
			{OTA_Pack_Len = 0;}
			
			taskENTER_CRITICAL();
			write_addr = (FLASH_APP_PATCH_ADDR + OTA_Pack_Len);
			iap_write_appbin(write_addr,pucRegBuffer,fileLength);
			OTA_Pack_Len += (fileLength*2);
			taskEXIT_CRITICAL();
			
			if(fileNumber == REG_FILE_NUMBER_END)//最后一帧
			{
				//STMFLASH_Write(USER_FLASH_ADDR_SOFTWARE_VERSION,&fileNumber,1); // 写版本信息 
				STMFLASH_Write(BOOT_FLASH_ADDR_OTA_PACK_LEN,(uint16_t*)&OTA_Pack_Len,2); // 写包长度 (含crc)
				sign = PRODUCT_BOOT_PASSWORD;
				STMFLASH_Write(BOOT_FLASH_ADDR_OTA_PASSWORD,(uint16_t*)&sign,2); // 进入OTA 

				SysSoftReset();// 软件复位
			}
			break;
		}
	}
	else
	{
			eStatus = MB_ENOREG;
	}
	return eStatus;
}

eMBErrorCode
eMBRegCoilsCB( UCHAR * pucRegBuffer, USHORT usAddress, USHORT usNCoils,
               eMBRegisterMode eMode )
{
	Clean_ModbusTimerCnt();
	//错误状态
	eMBErrorCode eStatus = MB_ENOERR;
//	//寄存器个数
//	int16_t iNCoils = ( int16_t )usNCoils;
//	//寄存器偏移量
//	int16_t usBitOffset;

//	//检查寄存器是否在指定范围内
//	if( ( (int16_t)usAddress >= REG_COILS_START ) &&
//	( usAddress + usNCoils <= REG_COILS_START + REG_COILS_SIZE ) )
//	{
//	//计算寄存器偏移量
//	usBitOffset = ( int16_t )( usAddress - REG_COILS_START );
//	switch ( eMode )
//	{
//	//读操作
//	case MB_REG_READ:
//	while( iNCoils > 0 )
//	{
//	*pucRegBuffer++ = xMBUtilGetBits( ucRegCoilsBuf, usBitOffset,
//	( uint8_t )( iNCoils > 8 ? 8 : iNCoils ) );
//	iNCoils -= 8;
//	usBitOffset += 8;
//	}
//	break;

//	//写操作
//	case MB_REG_WRITE:
//	while( iNCoils > 0 )
//	{
//	xMBUtilSetBits( ucRegCoilsBuf, usBitOffset,
//	( uint8_t )( iNCoils > 8 ? 8 : iNCoils ),
//	*pucRegBuffer++ );
//	iNCoils -= 8;
//	}
//	break;
//	}

//	}
//	else
//	{
//	eStatus = MB_ENOREG;
//	}
	return eStatus;
}

eMBErrorCode
eMBRegDiscreteCB( UCHAR * pucRegBuffer, USHORT usAddress, USHORT usNDiscrete )
{
	Clean_ModbusTimerCnt();
	//错误状态
	eMBErrorCode eStatus = MB_ENOERR;
//	//操作寄存器个数
//	int16_t iNDiscrete = ( int16_t )usNDiscrete;
//	//偏移量
//	uint16_t usBitOffset;

//	//判断寄存器时候再制定范围内
//	if( ( (int16_t)usAddress >= REG_DISCRETE_START ) &&
//	( usAddress + usNDiscrete <= REG_DISCRETE_START + REG_DISCRETE_SIZE ) )
//	{
//	//获得偏移量
//	usBitOffset = ( uint16_t )( usAddress - REG_DISCRETE_START );

//	while( iNDiscrete > 0 )
//	{
//	*pucRegBuffer++ = xMBUtilGetBits( ucRegDiscreteBuf, usBitOffset,
//	( uint8_t)( iNDiscrete > 8 ? 8 : iNDiscrete ) );
//	iNDiscrete -= 8;
//	usBitOffset += 8;
//	}

//	}
//	else
//	{
//	eStatus = MB_ENOREG;
//	}
	return eStatus;
}




void Modbus_Init(void)
{
	
	// 先写死 0xAA  wuqingguang
	//if( (*p_Local_Address >= 0xFF) || (*p_Local_Address == 0) )
	{
		*p_Local_Address = MODBUS_LOCAL_ADDRESS;	// 默认 0xAA
	}
	eMBInit( MB_RTU, *p_Local_Address, 0, 115200, MB_PAR_ODD);//初始化modbus，走modbusRTU，从站地址为0xAA，串口为2。
	eMBEnable(  );//使能modbus
	
}

void Modbus_Handle_Task(void)
{
	( void )eMBPoll(  );//启动modbus侦听
	
	if(ModbusTimerCnt++ > MODBUS_RESTART_TIMEOUT)
	{
		ModbusTimerCnt = 0;
		vMBPortSerialEnable( TRUE, FALSE );
//		memset(UART_BUF,0,sizeof(UART_BUF));
//		HAL_FLASH_Unlock();						//解锁
//		STMFLASH_Read(FLASH_APP_PROGRAM_ADDR+(Number*238),(uint16_t*)&UART_BUF[10],0x77);
//		HAL_FLASH_Lock();							//上锁
//		memcpy(UART_BUF,temp,10);
//		UART_BUF[7] = Number;
//		Number++;
//		HAL_UART_Transmit(&huart5,UART_BUF,250,0xffff);
//		HAL_Delay(50);
	}
}



// *********  Buf 相关数据接口  *************************************

void Modbus_Buffer_Init(void)
{
	STMFLASH_Read(FLASH_APP_PARAM_ADDR, usRegHoldingBuf, REG_HOLDING_NREGS );
	
	// 默认波特率  测试用
	Set_DataAddr_Value(MB_FUNC_READ_HOLDING_REGISTER,MB_DATA_ADDR_BAUD_RATE,3);
	Set_DataAddr_Value(MB_FUNC_READ_HOLDING_REGISTER,MB_DATA_ADDR_METERING_MODULE_BAUD,3);
	
}

void MB_Flash_Buffer_Write(void)
{
//扇区是2048， 整个 usRegHoldingBuf 一起写
	STMFLASH_Write(FLASH_APP_PARAM_ADDR, usRegHoldingBuf, REG_HOLDING_NREGS );
}



uint16_t* Get_DataAddr_Pointer(UCHAR ucFunctionCode, USHORT addr)
{
	if(ucFunctionCode == MB_FUNC_READ_HOLDING_REGISTER)
	{
		if(addr <= REG_HOLDING_NREGS)
		{
			return &usRegHoldingBuf[addr];
		}
	}
	else if(ucFunctionCode == MB_FUNC_READ_INPUT_REGISTER)
	{
		if(addr <= REG_INPUT_NREGS)
		{
			return &usRegInputBuf[addr];
		}
	}
	
	return NULL;
}


uint16_t Get_DataAddr_Value(UCHAR ucFunctionCode, USHORT addr)
{
	if(ucFunctionCode == MB_FUNC_READ_HOLDING_REGISTER)
	{
		if(addr <= REG_HOLDING_NREGS)
		{
			return usRegHoldingBuf[addr];
		}
	}
	else if(ucFunctionCode == MB_FUNC_READ_INPUT_REGISTER)
	{
		if(addr <= REG_INPUT_NREGS)
		{
			return usRegInputBuf[addr];
		}
	}
	
	return NULL;
}

void Set_DataAddr_Value(UCHAR ucFunctionCode, USHORT addr, uint16_t value)
{
	if(ucFunctionCode == MB_FUNC_READ_HOLDING_REGISTER)
	{
		if(addr <= REG_HOLDING_NREGS)
		{
			usRegHoldingBuf[addr] = value;
		}
	}
	else if(ucFunctionCode == MB_FUNC_READ_INPUT_REGISTER)
	{
		if(addr <= REG_INPUT_NREGS)
		{
			usRegInputBuf[addr] = value;
		}
	}
}

void Set_DataValue_U32(UCHAR ucFunctionCode, USHORT addr, uint32_t value)
{
	//taskENTER_CRITICAL();
	Set_DataAddr_Value( ucFunctionCode, addr, value>>16 );
	Set_DataAddr_Value( ucFunctionCode, addr+1, value&0xFFFF );
	//taskEXIT_CRITICAL();
}


void Set_Dmx512_Data(uint8_t* p_buff, uint16_t len)
{
	uint16_t i,j,sum;
	sum = len/2;
	if(len%2)
		sum++;
	taskENTER_CRITICAL();
	for(i=0,j=0; i<sum; i++,j+=2)
	{
		if( (REG_DATA_ADDR_DMX512_START+i) > REG_DATA_ADDR_DMX512_END )
			break;
		usRegHoldingBuf[REG_DATA_ADDR_DMX512_START+i] = *(p_buff+j) << 8;
		usRegHoldingBuf[REG_DATA_ADDR_DMX512_START+i] |= *(p_buff+j+1);
	}
	taskEXIT_CRITICAL();
}


uint8_t Get_Dmx512_Data_Change(void)
{
	return Dmx512_Data_Change_Sign;
}

void Set_Dmx512_Data_Change(uint8_t type)
{
	Dmx512_Data_Change_Sign = type;
}
