Marksman124/center_control/(commit log)

2024-03-08 添加调试模式
2024-03-14 OTA调试完成
    [协议转换表.xlsx]
2024-03-21 v2.0.2
    添加串口5调试功能；
2024-03-21 bin文件重命名
2024-03-26 版本2.0.2 添加从监听模式退出调试模式
2024-03-27 v2.0.2 将调试模式移至预编译由 SYSTEM_SOFTWARE_DEBUG 开关； 正常下串口5还是可以监听，但调试功能必须打开宏定义；
2024-04-03 添加 dmx512 和 电表 串口可设置；
    设置为 灯光 串口1
    电表 串口4
2024-04-07 v2.0.2
    添加原理图
    串口1 和 4 功能对调（电表 & DMX512灯 由于硬件布线错误）
2024-04-08 上传缺失补齐
2024-04-09 添加文档
    [中控MCU软件自测报告.xlsx]
2024-04-09 尝试使用串口5调试
2024-04-10 v2.0.2 重新规划调试串口，未完成
2024-04-12 v2.1.0 开启串口3 debug； 用自定义协议格式
2024-04-15 v2.1.1 pwm输出错误修改； 调试模式5秒切换接实际水泵等设施会有问题，暂时改至稳定输出最大档位，不做切换；
2024-05-06 v2.37.4
    1.修改电表DMA接收长度 ；
    2.modbus协议修改，001A 总有功功率（三相）单位改为 0.001kw ；
    3.修改调试预编译时编译不过的bug ；
2024-05-06 v2.37.4
    1.修改03功能码 寄存器读取错误；
    2. 从站地址 比特率 参数写死，不可更改
    3. modus 线程速度调高，发送间隔200ms 下正确率100%
    [中控MCU软件自测报告—V2.2主板.xlsx]
2024-05-08 v2.37.5
    1.修改单相型电表读取电量错误的bug；
    2.将寄存器读取放入临界区；
    [中控MCU软件自测报告—V2.2主板.xlsx]
2024-05-15 v2.37.6
    1.添加io输出口控制，P23 6个输出IO，可用作灯控制；
    2.优化io控制驱动，水泵档位接口调整，已验证功能；
2024-05-27 v2.37.6
    添加dmx自动发送间隔--》2s
2024-08-01 失误，水泵io控制测试代码忘记删了
