Marksman124/center_control/(notices)

Notices in the files:
center_control_app/Core/Inc/usart.h:
Copyright (c) 2023 STMicroelectronics.
All rights reserved.
This software is licensed under terms that can be found in the LICENSE file
center_control_app/Core/Src/main.c:
© Copyright (c) 2021 STMicroelectronics.
This software component is licensed by ST under BSD 3-Clause license,
the "License"; You may not use this file except in compliance with the
License. You may obtain a copy of the License at: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
